HARRMOS/ummati-deco/conformite/H_Modeles_courriers.md

# H — Modèles de courriers

## H1 — Demande de déclarations RoHS / REACH à un fournisseur

> Objet : Demande de déclarations de conformité RoHS et REACH — [référence du composant]

Bonjour,

Nous intégrons votre produit **[référence exacte]** (commande n° [À COMPLÉTER] du [date]) dans un appareil électronique mis sur le marché de l'Union européenne.

Pourriez-vous nous transmettre :

1. la **déclaration de conformité RoHS** (directive 2011/65/UE modifiée par la directive (UE) 2015/863) pour cette référence ;
2. une **déclaration REACH** indiquant la présence éventuelle de substances de la liste candidate (SVHC) au-delà de 0,1 % en masse ;
3. le cas échéant, la fiche technique à jour.

Merci par avance.
[Nom] — INOMA — [e-mail]

*(English version)* Hello, we integrate your product [part number] (order [number]) into an electronic device placed on the EU market. Could you please send us: (1) the RoHS declaration of conformity (Directive 2011/65/EU as amended by (EU) 2015/863) for this part number, (2) a REACH declaration regarding SVHC substances above 0.1% w/w, (3) the current datasheet. Thank you. [Name] — INOMA

## H2 — Demande de devis à un laboratoire

> Objet : Demande de devis — pré-essais / essais CEM et sécurité, appareil radio Wi-Fi 5 V

Bonjour,

Je souhaite un devis pour un petit appareil grand public :

- lecteur audio décoratif, **Wi-Fi 2,4 GHz** via module certifié **ESP32-S3-WROOM-1** (rapports RED du module disponibles), **Bluetooth désactivé** ;
- alimentation **5 V USB-C** (chargeur non fourni), consommation max ≈ [À COMPLÉTER] W, pas de batterie ;
- boîtier plastique imprimé 3D, dimensions 170 × 78 × 150 mm ; ampli classe D 3 W, 2 haut-parleurs, LED.

Prestations souhaitées (merci de chiffrer séparément) :

1. **pré-scan** d'émissions rayonnées et conduites (demi-journée) ;
2. essais CEM selon **EN 301 489-1 / -17** ;
3. éventuellement : revue sécurité EN 62368-1, avis sur l'exploitation des rapports du module (EN 300 328), revue EN 18031-1 ;
4. possibilité de **location de créneau** pour mesures accompagnées.

Merci d'indiquer délais et conditions.
[Nom] — INOMA — [téléphone, e-mail]

## H3 — Demande de devis d'assurance RC produits

> Objet : Demande de devis — responsabilité civile professionnelle et produits (après livraison)

Bonjour,

Micro-entreprise INOMA (SIRET [À COMPLÉTER]), je fabrique et vends en ligne un **appareil électronique décoratif basse tension (5 V USB, sans batterie, sans secteur)**, en boîtier imprimé en 3D.

- Volumes prévus : [À COMPLÉTER] unités / an ; CA prévisionnel : [À COMPLÉTER] € ;
- Pays de vente : [France / UE] ; canaux : site propre, [Etsy…].

Je souhaite un devis incluant la **RC après livraison (responsabilité du fait des produits)**, la RC exploitation, et si possible une **protection juridique**. Merci de préciser plafonds, franchises, exclusions (rappel de produits, ventes hors UE).

[Nom] — [e-mail]

## H4 — Demande de documents au fabricant du module (si introuvables en ligne)

> Objet : ESP32-S3-WROOM-1 — RED test reports and EU Declaration of Conformity

Hello, we are integrating the ESP32-S3-WROOM-1 module ([exact variant, e.g. N16R8]) unmodified, with its integrated PCB antenna, into a consumer product sold in the EU. Could you please provide the EU Declaration of Conformity and the RED test reports (EN 300 328, EN 301 489-1/-17, EN 62368-1, RF exposure) for this module, as well as the latest integration / hardware design guidelines? Thank you. [Name] — INOMA

## H5 — Réponse type à une réclamation sécurité

Bonjour [Nom],

Merci de nous avoir signalé ce problème. Par précaution, **débranchez l'appareil et ne l'utilisez plus** jusqu'à notre retour. Pourriez-vous nous envoyer : le numéro de série (étiquette sous l'appareil), des photos, le chargeur utilisé et une description de ce qui s'est passé ?

Nous revenons vers vous sous 48 h avec une solution (réparation, remplacement ou remboursement).

[Nom] — INOMA
