HARRMOS/ummati-deco/conformite/AYAH_Dossier_conformite.pdf

I N O M A

# AYAH AY-R1 Dossier de conformité et de commercialisation

### Version de travail 0.1 — 2 novembre 2026

Base de travail, pas une attestation de conformité ni un avis juridique.

### Toutes les mentions [À COMPLÉTER], [À VÉRIFIER] et [PREUVE] doivent être traitées avant

signature de la déclaration UE.

# AYAH — Dossier de conformité et de commercialisation

Produit : AYAH « Radio », référence AY-R1 — marque INOMA
Version du dossier : 0.1 (brouillon) — 2 novembre 2026

⚠️ Ce dossier est une base de travail, pas une attestation de conformité ni un avis juridique. Il a été préparé avec l'aide d'une IA. Tu signes la déclaration UE : chaque affirmation doit être vraie, vérifiée et prouvée.

## Hypothèses de cette version du produit

Élément | Choix retenu | Si tu changes ce choix
Radio | Wi-Fi 2,4 GHz uniquement, module ESP32-S3-WROOM-1
certifié, antenne intégrée

Ajouter du Bluetooth → inscription Bluetooth SIG + réévaluation
Bluetooth | Désactivé dans le firmware, non annoncé | —
Contenu
audio
| | Aucun enregistrement fourni | Fournir des récitations → licences écrites
obligatoires
Alimentation USB-C 5 V, chargeur non fourni, courant limité (fusible réarmable ≤ 2 A)
| | | Fournir un chargeur → il doit être conforme et
documenté
Batterie | Aucune | Batterie → règlement batteries + essais
supplémentaires
Boîtier | Impression 3D (PLA ou PETG), visserie M3 | Changement de matière → refaire l'analyse
thermique/incendie

## Conventions

[À COMPLÉTER] : une information que toi seul connais (adresse, SIRET, numéro de lot…).
[À VÉRIFIER] : un point à confirmer dans un texte officiel, auprès d'un organisme ou d'un laboratoire. [PREUVE] : un document réel à joindre (mesure, photo, rapport, déclaration fournisseur). Ne jamais l'inventer.

## Contenu du dossier

# | Document | Rôle | Qui le voit

A Dossier technique | Démontre la conformité (RED, RoHS, sécurité, cyber) | Toi + autorités sur demande
B Déclaration UE de conformité L'engagement signé | Public (notice ou site)
C Notice d'utilisation | Consignes obligatoires en français | Client
D Étiquetage et emballage | Marquages sur l'appareil et la boîte | Client
E Documents de vente | CGV, mentions légales, confidentialité, rétractation | Client
F Démarches administratives | DEEE, emballages, médiateur, assurance, marque, Bluetooth | Toi
G Procédures internes | Lots, réclamations, rappels, failles, mises à jour | Toi
H Modèles de courriers | Demandes aux fournisseurs, labo, assureur | Toi

## Ordre de travail recommandé

1. Figer le design : composants définitifs, firmware, boîtier → remplir A §1 à §3.
2. Collecter les preuves fournisseurs (courriers H) : rapports Espressif, déclarations RoHS.
3. Faire les mesures : températures (A §6) et perturbations électromagnétiques (A §7).
4. Cybersécurité : implémenter et documenter A §8.
5. Démarches F : entreprise, éco-organisme DEEE, emballages, médiateur, assurance.
6. Rédiger notice (C), étiquettes (D), documents de vente (E).
7. Relire tout, puis signer la déclaration B.
8. Archiver l'ensemble 10 ans (une copie par version du produit).

## Ce qui reste payant (à prévoir)

Les textes des normes (EN 62368-1, EN 301 489…) sont vendus par l'AFNOR. Une consultation gratuite est parfois possible dans certaines bibliothèques et CCI [À VÉRIFIER]. Un laboratoire les applique pour toi s'il fait les essais.
Les cotisations éco-organisme / emballages / médiateur (faibles), l'assurance (recommandée).

# A — Dossier technique AYAH AY-R1

À conserver 10 ans après la mise sur le marché du dernier exemplaire. Une version du dossier par version du produit.

## 1. Identification

Champ | Valeur
Fabricant | INOMA — [À COMPLÉTER : forme juridique, nom du responsable]
Adresse postale | [À COMPLÉTER]
SIREN / SIRET | [À COMPLÉTER]
Contact | [À COMPLÉTER : e-mail dédié, ex. contact@…]
Nom commercial | AYAH « Radio »
Référence modèle | AY-R1
Variantes (coloris) | AY-R1-VE (vert), AY-R1-NO (noir), AY-R1-IV (ivoire) — électronique identique
Version matérielle | [À COMPLÉTER : ex. HW 1.0]
Version firmware | [À COMPLÉTER : ex. FW 1.0.0, empreinte SHA-256 du binaire]
Numérotation des lots | Voir G §1

## 2. Description du produit

Usage prévu : objet de décoration lumineux et lecteur audio pour usage domestique intérieur, posé sur un meuble. Permet d'écouter des fichiers audio fournis par l'utilisateur ou un service compatible, de régler le volume et l'éclairage d'ambiance. Ce n'est pas un jouet.

Utilisations exclues : extérieur, salle de bain, milieu humide, véhicule, exposition directe au soleil ou près d'une source de chaleur.

Fonctions :

lecture audio (ampli I2S 3 W, 2 haut-parleurs Ø40 mm 8 Ω en parallèle) ;
éclairage LED blanc chaud (LED adressables, intensité limitée par logiciel) ;
commandes : 3 touches tactiles capacitives, 1 encodeur rotatif avec poussoir ;
connexion Wi-Fi 2,4 GHz (IEEE 802.11 b/g/n) pour la configuration, les mises à jour et le pilotage depuis une application ;
Bluetooth matériellement présent dans le module mais désactivé par le firmware et non accessible à l'utilisateur.

Alimentation : 5 V continu par connecteur USB-C. Courant d'entrée limité par fusible réarmable [À COMPLÉTER : référence, courant de maintien ≤ 2 A]. Chargeur non fourni. Pas de batterie.

Dimensions / masse : 170 × 78 × 150 mm — [À COMPLÉTER : masse mesurée] g.

Matériaux accessibles : [À COMPLÉTER : PLA ou PETG, marque et référence du filament], visserie acier zingué ou inox, inserts laiton.

[PREUVE] Photos à joindre : vues avant, arrière, dessus, dessous, intérieur ouvert, circuit imprimé recto/verso, étiquette.

## 3. Conception et fabrication

Document | Référence / emplacement | Statut
Schéma électronique | [À COMPLÉTER : fichier, version] | ☐
Circuit imprimé (fichiers de fabrication) | [À COMPLÉTER] | ☐
Nomenclature (BOM) avec fournisseurs | Tableau §3.1 | ☐
Plans mécaniques (STL/STEP) | radio/stl, radio/step (version figée : [À COMPLÉTER : tag Git]) | ☐
Firmware (code source + binaire) | firmware/ (tag Git : [À COMPLÉTER]) | ☐
Procédure de fabrication et contrôles | G §2 | ☐

### 3.1 Nomenclature des composants critiques

Fonction | Composant | Fabricant / réf. | Fournisseur

Déclaration
RoHS

Certification utile

Module radio + MCU ESP32-S3-WROOM-1-N16R8

Espressif | [À
COMPLÉTER]
☐ | Rapports RED du module ☐
Ampli audio | MAX98357A | Analog Devices
(Maxim)

[À
COMPLÉTER]
☐ | —
Haut-parleurs ×2 | Ø40 mm 8 Ω | [À COMPLÉTER] | [À
COMPLÉTER]
☐ | —
LED | [À COMPLÉTER] | [À COMPLÉTER] | ☐ | —
Encodeur | EC11 | [À COMPLÉTER] | ☐ | —
Connecteur USB-C | [À COMPLÉTER] | ☐ | —
Fusible réarmable | [À COMPLÉTER] | ☐ | —
Boîtier | Filament [À
COMPLÉTER]
☐ | Fiche technique
(température, classement
feu) ☐
Circuit imprimé nu +
assemblage
[À COMPLÉTER] | ☐ | —

## 4. Exigences applicables et normes

Les versions des normes doivent être vérifiées dans la liste des normes harmonisées publiée au Journal officiel de l'UE (site de la Commission, « harmonised standards ») à la date de la déclaration. [À VÉRIFIER pour chaque ligne]

Texte | Exigence | Norme(s) de référence | Méthode retenue | Résultat
RED 2014/53/UE art.
3.1(a)
Santé, sécurité | EN IEC 62368-1
[version]

Évaluation sur dossier + essais thermiques (§6)

☐

Exposition aux champs EN 62479 / EN 62311 [version]

Reprise de l'évaluation du module + calcul (§5)

☐

RED art. 3.1(b) | Compatibilité
électromagnétique

EN 301 489-1 et EN 301
489-17 [versions]
Mesures sur le produit fini (§7) | ☐
RED art. 3.2 | Utilisation efficace du
spectre

EN 300 328 [version] Reprise des rapports du module certifié (§5)

☐

RED art. 3.3(d)(e)(f) —
Règlement délégué (UE)
2022/30
Cybersécurité | EN 18031-1 [version] (et
-2 si données
personnelles)

Évaluation documentée (§8) — vérifier les restrictions de la citation au JOUE

☐

Texte | Exigence | Norme(s) de référence | Méthode retenue | Résultat
RoHS 2011/65/UE (+ dir. déléguée 2015/863) | Substances dangereuses | EN IEC 63000 | Déclarations fournisseurs (§9) | ☐
Règlement (UE) 2023/988 (GPSR) | Sécurité générale | — | Analyse de risques (§10), traçabilité, information | ☐
Écoconception veille — Règlement (UE) 2023/826 | Consommation en veille / veille réseau | — | [À VÉRIFIER : applicabilité] ; mesure de la consommation au repos (§6.3) | ☐
REACH (CE 1907/2006) | Substances extrêmement préoccupantes (SVHC) | — | Déclarations fournisseurs (§9) | ☐
DEEE 2012/19/UE | Marquage, filière | — | Voir F | ☐

Non applicables (avec justification) :

Directive basse tension 2014/35/UE : couverte par la RED pour un équipement radio (et tension < 75 V continu).
EN 61000-3-2 / -3-3 (harmoniques, flicker réseau) : appareil alimenté en 5 V continu, non raccordé directement au réseau 230 V [À VÉRIFIER avec le labo].
Règlement batteries : aucune batterie.
Directive jouets : produit non destiné aux enfants de moins de 14 ans, mention « Ce n'est pas un jouet ».

## 5. Radio et exposition aux ondes — intégration du module certifié

Principe : les essais radio (EN 300 328) et l'évaluation d'exposition sont repris des rapports du fabricant du module, à condition de respecter strictement ses consignes d'intégration.

Condition d'intégration (guide Espressif) | Respectée ? | Preuve
Module utilisé sans modification, antenne PCB intégrée d'origine | ☐ | Photo du circuit
Zone sans cuivre / sans métal sous et autour de l'antenne (selon le guide) | ☐ | Plan du circuit
Antenne éloignée des vis, inserts, haut-parleurs (aimants) | ☐ | Photo intérieur
Puissance d'émission et paramètres radio non modifiés au-delà des réglages autorisés | ☐ | Extrait firmware
Bandes : 2,4 GHz uniquement | ☐ | —

[PREUVE] À télécharger chez Espressif et joindre : déclaration UE et rapports d'essais RED du module ESP32-S3-WROOM-1 (EN 300 328, EN 301 489, EN 62368-1, évaluation d'exposition), et le guide de conception matérielle du module. Noter la version et la date de chaque document.

Exposition : [À COMPLÉTER : puissance maximale déclarée par le module, conclusion de l'évaluation du module, distance d'utilisation (> 20 cm en usage normal, objet posé)].

## 6. Sécurité électrique et thermique (EN IEC 62368-1)

### 6.1 Classification des sources d'énergie [À VÉRIFIER avec le texte de la norme]

Énergie | Classe visée Justification
Électrique | ES1 | 5 V continu
Puissance (incendie) | PS1 visé | Puissance disponible limitée à ≤ 15 W par fusible réarmable ≤ 2 A — [PREUVE : mesure
de la puissance max. disponible en défaut] Thermique (surfaces
touchables)
TS1 visé | Mesures §6.2
Mécanique | MS1 | Objet léger, stable, pas de pièce mobile dangereuse, bords arrondis

Énergie

Classe
visée

Justification

Rayonnement (LED) | RS1 visé | LED d'éclairage d'ambiance, intensité limitée — [À VÉRIFIER]

### 6.2 Essai d'échauffement — protocole

1. Appareil assemblé, fermé, posé sur un support bois, pièce à 23 ± 2 °C.
2. Alimentation 5 V avec un chargeur conforme 3 A.
3. Cas le plus défavorable : volume maximal (bruit rose ou récitation forte), LED à l'intensité maximale autorisée par le firmware, Wi-Fi actif, 4 h minimum (jusqu'à stabilisation).
4. Thermocouples ou sonde sur : ESP32, ampli, LED, connecteur USB, fusible, boîtier intérieur au plus chaud, surfaces extérieures touchables (dessus, grille, molette).
5. Cas de défaut : un haut-parleur en court-circuit, LED bloquées à 100 % (si possible par logiciel), sortie de l'ampli en court-circuit [À VÉRIFIER : défauts à simuler selon la norme].
Point de mesure | T max mesurée (°C) | Limite applicable | OK ?
Surface extérieure dessus | [PREUVE] | [À VÉRIFIER : limite de toucher pour plastique] | ☐
Grille / molette | [PREUVE] | ☐
Boîtier intérieur (près ampli) [PREUVE] | < température de ramollissement du filament – marge (PLA ≈ 55 °C) ☐
ESP32 | [PREUVE] | Selon fiche technique | ☐
Ampli | [PREUVE] | Selon fiche technique | ☐
Connecteur USB | [PREUVE] | ☐

[PREUVE] Photos du montage d'essai, relevés horodatés.

### 6.3 Consommation

Mode | Puissance mesurée (W)
Lecture volume max + LED max | [PREUVE]
Repos, LED éteintes, Wi-Fi connecté (veille réseau) | [PREUVE]
Repos, Wi-Fi coupé | | | [PREUVE]

### 6.4 Autres points de sécurité

Matériau du boîtier : [À COMPLÉTER : classement au feu du filament si disponible]. En PS1, pas d'exigence d'enveloppe coupe-feu [À VÉRIFIER].
Aucune arête vive ; petites pièces (touches, molette) non détachables sans outil — [PREUVE : essai de traction, ex. 50 N] [À VÉRIFIER valeur].
Stabilité : ne bascule pas sur un plan incliné de 10° [À VÉRIFIER] — [PREUVE].
Chute d'une table (≈ 75 cm) : pas de pièce dangereuse accessible — [PREUVE].

## 7. Compatibilité électromagnétique (EN 301 489-1 / -17)

Méthode : [À CHOISIR : essais complets en laboratoire / pré-tests maison + demi-journée en laboratoire].

### 7.1 Plan d'essais

Phénomène | Essai | Port | Configuration | Critère d'aptitude
Émissions rayonnées | Selon EN 301 489-1 (renvoi EN 55032, classe B) | Enveloppe | Lecture audio volume max + LED + Wi-Fi | Limites classe B

Phénomène | Essai | Port | Configuration | Critère d'aptitude
Émissions conduites | Idem | Câble USB (via
chargeur de référence)
Idem | Limites classe B

Décharges
électrostatiques
EN 61000-4-2 | Touches, molette, grille,
vis, USB

En fonctionnement Critère B (récupération seule) [À VÉRIFIER]
Champ rayonné | EN 61000-4-3 | Enveloppe | Lecture | Critère A [À VÉRIFIER]
Transitoires rapides /
ondes de choc

EN 61000-4-4 / -4-5 Alimentation (si applicable, via
chargeur)

[À VÉRIFIER
applicabilité pour port
DC]
Perturbations conduites
RF
EN 61000-4-6 | Câble USB | [À VÉRIFIER]

### 7.2 Résultats

Essai | Lieu, date, matériel (n° de série, étalonnage) | Résultat | Marge | Conforme ?
[PREUVE] | [PREUVE] | ☐

Mesures de conception déjà prises : plan de masse, découplages, ferrites sur USB et fils HP, fils HP courts et torsadés, résistances série sur horloges I2S/SPI, modulation étalée de l'ampli active.

## 8. Cybersécurité (EN 18031-1)

Structure à confronter au texte de la norme (mécanismes : contrôle d'accès, authentification, mise à jour sécurisée, stockage sécurisé, communication sécurisée, résilience, surveillance réseau, contrôle du trafic, clés cryptographiques confidentielles, capacités générales, cryptographie). [À VÉRIFIER : restrictions de présomption de conformité dans la citation au JOUE — certains choix imposent un organisme notifié.]

Mécanisme | Mise en œuvre AYAH | Preuve
Pas de mot de passe par
défaut commun

Configuration initiale : point d'accès temporaire protégé par un code unique par appareil imprimé sous l'appareil, ou appairage par l'appli avec confirmation physique (appui molette)

Extrait de code,
procédure

Authentification des
commandes réseau

API locale accessible uniquement après appairage ; jeton unique par appareil ; aucune commande sans authentification

☐

Mises à jour sécurisées OTA signées (vérification de signature avant installation), démarrage sécurisé (Secure Boot v2) et chiffrement de la flash activés en production, retour arrière automatique en cas d'échec

☐

Stockage sécurisé | Identifiants Wi-Fi et jetons stockés en NVS chiffrée ; aucun secret en clair dans les
journaux

☐

Communication sécurisée TLS pour tout échange avec un serveur ; vérification du certificat | ☐
Résilience | Limitation des tentatives, redémarrage sûr, chien de garde | ☐
Surface d'attaque
minimale

Bluetooth désactivé ; aucun port de débogage accessible ; services réseau limités au strict nécessaire

☐

Réinitialisation | Remise à zéro usine (appui long) effaçant identifiants et jetons | ☐
Gestion des vulnérabilités Procédure G §5 | ☐
Données personnelles | [À COMPLÉTER : aucune / liste] — si oui, EN 18031-2 et RGPD | ☐

## 9. Substances (RoHS, REACH)

Composant | Déclaration RoHS reçue (date) | Déclaration REACH / SVHC | Commentaire
(un par ligne de la nomenclature §3.1) | [PREUVE] | [PREUVE]

Méthode : approche EN IEC 63000 — collecte des déclarations fournisseurs, évaluation des fournisseurs, archivage. Modèle de demande : H §1.

## 10. Analyse de risques (sécurité générale)

Gravité : 1 mineure · 2 sérieuse · 3 grave. Probabilité : 1 rare · 2 possible · 3 probable.

# | Danger | Situation | G | P | Mesures

G×P
résiduel

Preuve

1 Échauffement /

| incendie | Utilisation prolongée, nuit, volume max

3 1 5 V limité, fusible, LED limitées, mesures
| | | | | §6.2, consignes notice
faible | §6.2

2 Déformation du
| boîtier

Soleil, voiture, radiateur 1 2 Consigne notice, filament [PETG
| | | | | recommandé]
faible | Notice

3 Ingestion de petites
| pièces
Enfant en bas âge | 3 1 Pièces non détachables sans outil, mention
| | | | | « hors de portée des jeunes enfants »
faible | §6.4
4 Choc électrique | — | 1 1 ES1 (5 V), pas de secteur dans l'appareil | négligeable §6.1
5 Chargeur non
| conforme | Client utilise un chargeur bas de gamme

2 2 Notice : « chargeur conforme CE 5 V / 3 A »
| | | | | ; fusible d'entrée
faible | Notice
6 Chute de l'objet | Bord de meuble | 1 2 Patins antidérapants, centre de gravité bas faible | §6.4
7 Volume sonore élevé Écoute proche | 1 1 Puissance 3 W, volume max limité par
| | | | | logiciel

négligeable —

8 Lumière
| (éblouissement)
Mode nuit | 1 1 LED diffusées, intensité limitée | négligeable —

9 Piratage / prise de
| contrôle
Réseau domestique | 2 2 Mesures §8 | faible | §8

10 Arêtes / bavures
| d'impression
Manipulation | 1 2 Contrôle visuel en fin de fabrication,
| | | | | ébavurage
faible | G §2

## 11. Conclusion et signature

La conformité est déclarée lorsque toutes les cases ☐ ci-dessus sont cochées avec leur preuve.

Établi par : [À COMPLÉTER], le [À COMPLÉTER] — Version du dossier : [À COMPLÉTER]

# B — Déclaration UE de conformité

Modèle à compléter uniquement après avoir terminé le dossier technique (A). Langue : français (ajouter les langues des autres pays de vente). À fournir avec le produit (intégrale ou simplifiée avec lien internet).

## DÉCLARATION UE DE CONFORMITÉ

N° : DoC-AY-R1-[À COMPLÉTER : version, ex. 01]

1. Produit : lecteur audio décoratif avec éclairage et connexion Wi-Fi Nom commercial : AYAH « Radio » Modèle / type : AY-R1 (variantes coloris AY-R1-VE, AY-R1-NO, AY-R1-IV) Version matérielle : [À COMPLÉTER] — Version logicielle : [À COMPLÉTER] Numéros de lot / série concernés : à partir du lot [À COMPLÉTER]
2. Fabricant : INOMA, [À COMPLÉTER : forme juridique], [À COMPLÉTER : adresse postale complète], France — [À COMPLÉTER : e-mail]
3. La présente déclaration de conformité est établie sous la seule responsabilité du fabricant.
4. Objet de la déclaration : l'appareil décrit au point 1, identifiable par l'étiquette portant sa référence et son numéro de lot. [Insérer une photo du produit — facultatif]
5. L'objet de la déclaration décrit ci-dessus est conforme à la législation d'harmonisation de l'Union applicable :
6. Directive 2014/53/UE (équipements radioélectriques), y compris le règlement délégué (UE) 2022/30 (articles 3.3 d, e, f) ;
7. Directive 2011/65/UE (RoHS), modifiée par la directive déléguée (UE) 2015/863.
8. [À VÉRIFIER : règlement (UE) 2023/826 si applicable]
9. Références des normes harmonisées appliquées (ou autres spécifications techniques) :
10. Article 3.1(a) — Sécurité : EN IEC 62368-1:[version] ; exposition : EN 62479:[version] ou EN 62311:[version]
11. Article 3.1(b) — CEM : EN 301 489-1 V[version] ; EN 301 489-17 V[version]
12. Article 3.2 — Spectre radio : EN 300 328 V[version]
13. Article 3.3(d)(e)(f) — Cybersécurité : EN 18031-1:[version]
14. RoHS : EN IEC 63000:[version]

[À VÉRIFIER] chaque version dans la liste officielle au JOUE à la date de signature.

15. Organisme notifié : sans objet — procédure d'évaluation : contrôle interne de la fabrication (annexe II de la directive 2014/53/UE).

⚠️ Si une norme n'est pas appliquée entièrement (ou si la citation de l'EN 18031-1 au JOUE l'exclut pour ton design), cette procédure n'est pas possible : un organisme notifié devient obligatoire.

16. Informations complémentaires : bande de fréquences 2 400–2 483,5 MHz ; puissance maximale émise : [À COMPLÉTER : valeur déclarée par le fabricant du module] dBm (PIRE). Accessoires : aucun chargeur fourni ; logiciel : firmware version [À COMPLÉTER].

Signé par et au nom de : INOMA

Lieu et date : [À COMPLÉTER], le [À COMPLÉTER]

Nom, fonction : [À COMPLÉTER], [ex. dirigeant]

Signature : ______________________

## Version simplifiée (à imprimer dans la notice)

Le soussigné, INOMA, déclare que l'équipement radioélectrique du type AYAH AY-R1 est conforme à la directive 2014/53/UE. Le texte complet de la déclaration UE de conformité est disponible à l'adresse internet suivante : [À COMPLÉTER : URL]

# C — Notice d'utilisation AYAH

Texte prêt à mettre en page (format A6 ou A5). Obligatoire en français. Adapter si le produit change. Relire avec le firmware final.

# AYAH « Radio »

Lecteur audio décoratif — modèle AY-R1

Merci d'avoir choisi AYAH. Lisez cette notice avant la première utilisation et conservez-la.

## Contenu de la boîte

1 AYAH « Radio »
Cette notice
[À COMPLÉTER : câble USB-C fourni ou non]

Chargeur non fourni. Utilisez un chargeur USB-C conforme CE, 5 V, 3 A minimum (par exemple celui d'un téléphone récent).

## Consignes de sécurité ⚠️

Usage intérieur uniquement, dans un endroit sec. Ne pas exposer à l'eau, à l'humidité ni aux projections. Ne pas placer au soleil direct, dans une voiture, ni près d'un radiateur ou d'une flamme : le boîtier imprimé peut se déformer à la chaleur.
Ne pas couvrir l'appareil pendant son fonctionnement.
Utiliser uniquement un chargeur conforme. Débrancher en cas d'odeur, de chaleur anormale ou de bruit inhabituel.
Ne pas ouvrir l'appareil branché. Aucune pièce réparable par l'utilisateur à l'intérieur, en dehors de celles décrites dans cette notice.
Ce n'est pas un jouet. Tenir hors de portée des enfants de moins de 3 ans (petites pièces).
Écouter à un volume modéré.
Posé sur une surface stable et plane, à distance du bord.

## Découvrir AYAH

Molette dorée (à droite) : tourner pour régler le volume ; appuyer pour lecture / pause ; [À COMPLÉTER : appui long = mode navigation / mode nuit].
Touches ◀ ⏯ ▶ : piste précédente, lecture/pause, piste suivante. Ce sont des touches tactiles : un simple effleurement suffit.
Éclairage : [À COMPLÉTER : comment allumer / régler / mode nuit].

## Mise en service

1. Posez AYAH sur une surface stable.
2. Branchez le câble USB-C au dos, puis au chargeur.
3. L'éclairage s'allume doucement : AYAH est prêt.

4. Connexion Wi-Fi (facultative) : [À COMPLÉTER : procédure avec l'application, code d'appairage unique situé sous l'appareil].

## Contenu audio

AYAH ne contient aucun enregistrement. [À COMPLÉTER selon la version : « Copiez vos propres fichiers MP3 sur la carte microSD » / « Choisissez un contenu depuis l'application compatible »]. Utilisez uniquement des contenus dont vous avez le droit de vous servir.

## Réinitialisation

Pour effacer les réglages et la connexion Wi-Fi : [À COMPLÉTER : ex. maintenir la molette enfoncée 10 secondes, appareil branché].

## Entretien

Dépoussiérer avec un chiffon sec et doux. Pas de produit liquide, pas d'eau.

## En cas de problème

Problème | Solution
Rien ne s'allume | Vérifier le chargeur (5 V / 3 A) et le câble
Pas de son | Monter le volume (molette) ; vérifier qu'un contenu est disponible
L'appareil redémarre au volume fort | Utiliser un chargeur plus puissant (3 A)
Wi-Fi introuvable | Réinitialiser l'appareil, recommencer la mise en service

## Caractéristiques techniques

Alimentation | 5 V ⎓, USB-C, [À COMPLÉTER : consommation max mesurée] W
Wi-Fi | IEEE 802.11 b/g/n, 2 400–2 483,5 MHz, puissance max. [À COMPLÉTER] dBm
Son | 2 haut-parleurs, amplificateur 3 W
Dimensions | 170 × 78 × 150 mm
Masse | [À COMPLÉTER] g
Température d'utilisation | [À COMPLÉTER : ex. 5 à 35 °C]
Mises à jour logicielles | Assurées au moins jusqu'au [À COMPLÉTER : date]

## Garanties

Ce produit bénéficie de la garantie légale de conformité (2 ans) et de la garantie des vices cachés. Voir les conditions générales de vente. Service client : [À COMPLÉTER : e-mail].

## Déclaration de conformité

Le soussigné, INOMA, déclare que l'équipement radioélectrique du type AYAH AY-R1 est conforme à la directive 2014/53/UE. Le texte complet de la déclaration UE de conformité est disponible à l'adresse : [À COMPLÉTER : URL].

## Recyclage

![poubelle barrée] Ce produit ne doit pas être jeté avec les ordures ménagères. Déposez-le dans un point de collecte d'équipements électriques (déchetterie, magasin). [À COMPLÉTER : mention de l'éco-organisme + Info-tri si requise]

## Fabricant

INOMA — [À COMPLÉTER : adresse postale] — [À COMPLÉTER : e-mail] — Modèle AY-R1 — Lot : voir étiquette sous l'appareil.

# D — Étiquetage de l'appareil et de l'emballage

## 1. Étiquette sous l'appareil (obligatoire)

Étiquette imprimée résistante (polyester) ou gravure directe dans le socle. Lisible, indélébile.

AYAH « Radio » | Modèle : AY-R1
Lot : AY-R1-2026-001 | N° : 0001
INOMA — [adresse postale] — [e-mail ou site]
5 V ⎓ [x] A — USB-C
Code d'appairage : XXXX-XXXX | (si prévu, unique par appareil)
CE | [poubelle barrée] | Fabriqué en France
Mention | Règle | Statut
Marquage CE | Hauteur ≥ 5 mm, proportions officielles, apposé après la déclaration | ☐
Poubelle barrée (DEEE) | Symbole de la norme EN 50419 ; barre noire sous la poubelle si exigée
(date de mise sur le marché) [À VÉRIFIER]

☐

Nom, raison sociale ou marque et adresse
postale du fabricant
Plus un moyen de contact électronique (GPSR) | ☐
Type / modèle + numéro de lot ou de série | Pour la traçabilité | ☐
Caractéristiques d'alimentation | 5 V ⎓, courant | ☐

Si la place manque sur l'appareil, certaines mentions (adresse) peuvent figurer sur l'emballage et la notice [À VÉRIFIER selon chaque texte] — le CE, le modèle et le lot restent sur l'appareil.

## 2. Emballage

Mention | Statut
Nom du produit, modèle, lot | ☐
Fabricant + adresse + contact | ☐
Marquage CE (recommandé aussi sur la boîte) | ☐
Poubelle barrée | ☐
Logo Triman + Info-tri pour l'emballage et le produit (règles françaises de tri) — [À VÉRIFIER : modèle à jour fourni par
ton éco-organisme emballages]

☐

« Chargeur non fourni » | ☐
« Ce n'est pas un jouet » / « Ne convient pas aux enfants de moins de 3 ans » (si petites pièces) | ☐
Pas de mention trompeuse (« certifié », « norme CE validée par… », logo Bluetooth si non inscrit) | ☐

## 3. Notice

La notice (C) accompagne chaque appareil, en français. Elle contient la déclaration de conformité simplifiée et les consignes de sécurité.

## 4. Mentions interdites ou à éviter

« Approuvé par l'Union européenne », « certifié CE » : le CE est une auto-déclaration, pas un label. Logo ou mot Bluetooth si non inscrit au Bluetooth SIG.

Logo Wi-Fi CERTIFIED sans certification Wi-Fi Alliance (le mot « Wi-Fi » descriptif reste possible [À VÉRIFIER]).
Promesses environnementales générales (« écologique », « neutre en carbone ») : encadrées par la loi.

# E — Documents de vente en ligne (vente aux particuliers)

Modèles de base pour une micro-entreprise vendant en France. Faire relire (CCI, juriste) avant mise en ligne. Les textes officiels à recopier mot pour mot sont signalés : les prendre sur Légifrance, pas de mémoire.

## E1 — Conditions générales de vente (CGV)

Article 1 — Vendeur. INOMA, [forme juridique], [adresse], SIRET [À COMPLÉTER], e-mail [À COMPLÉTER], téléphone [facultatif]. [Si franchise de TVA : « TVA non applicable, art. 293 B du CGI ».]

Article 2 — Objet. Les présentes CGV régissent la vente à distance des produits AYAH aux consommateurs, via le site [À COMPLÉTER]. Toute commande vaut acceptation des CGV en vigueur au jour de la commande.

Article 3 — Produits. Les caractéristiques essentielles figurent sur chaque fiche produit (dimensions, alimentation, fonctions, chargeur non fourni, aucun contenu audio fourni). Les produits sont fabriqués à la main par impression 3D : de légères variations d'aspect sont possibles et ne constituent pas un défaut.

Article 4 — Prix. Prix en euros TTC [ou « TVA non applicable »], hors frais de livraison indiqués avant validation. Éco-participation incluse et affichée séparément : [À COMPLÉTER] €.

Article 5 — Commande. Étapes : choix du produit, panier, identification, récapitulatif, bouton « Commander avec obligation de paiement », paiement, confirmation par e-mail (récapitulatif + CGV en pièce jointe).

Article 6 — Paiement. Par [carte bancaire via Stripe / PayPal]. Paiement exigible à la commande.

Article 7 — Livraison. Zones : [France métropolitaine / UE]. Délai : [À COMPLÉTER] jours ouvrés après paiement (fabrication incluse). À défaut d'indication, livraison au plus tard 30 jours après la commande. En cas de retard, le client peut résoudre la vente dans les conditions légales. Transfert des risques à la remise du colis au client.

Article 8 — Droit de rétractation. Le client dispose de 14 jours à compter de la réception pour se rétracter, sans motif, en utilisant le formulaire (E4) ou toute déclaration claire. Retour du produit dans les 14 jours suivant la rétractation, frais de retour à la charge du client [ou : pris en charge par INOMA]. Remboursement de toutes les sommes versées, y compris les frais de livraison standard, sous 14 jours, par le même moyen de paiement. Le vendeur peut différer le remboursement jusqu'à récupération du produit. La responsabilité du client peut être engagée en cas de dépréciation du produit résultant de manipulations autres que celles nécessaires pour établir sa nature, ses caractéristiques et son bon fonctionnement.

Si tu proposes une personnalisation (gravure d'un nom…) : le droit de rétractation ne s'applique pas aux biens nettement personnalisés — l'indiquer clairement sur la fiche produit [À VÉRIFIER].

Article 9 — Garanties légales. Le vendeur est tenu de la garantie légale de conformité (articles L. 217-1 et suivants du Code de la consommation) et de la garantie des vices cachés (articles 1641 et suivants du Code civil).

Obligatoire : insérer ici, mot pour mot, l'encadré d'information sur la garantie légale de conformité prévu par la réglementation (décret n° 2022-946 du 29 juin 2022) — [À COPIER depuis Légifrance].

Article 10 — Pièces détachées et mises à jour. Pièces détachées indispensables à l'utilisation disponibles jusqu'au [À COMPLÉTER : date ou « information non disponible »] (mention obligatoire pour les équipements électriques — [À VÉRIFIER]). Mises à jour logicielles de sécurité fournies au moins jusqu'au [À COMPLÉTER].

Article 11 — Responsabilité. Le vendeur n'est pas responsable des contenus audio ajoutés par l'utilisateur, ni d'une utilisation non conforme à la notice (chargeur non conforme, exposition à la chaleur ou à l'humidité).

Article 12 — Données personnelles. Voir la politique de confidentialité (E3).

Article 13 — Médiation. En cas de litige non résolu avec le service client, le consommateur peut recourir gratuitement au médiateur de la consommation : [À COMPLÉTER : nom, site internet, adresse du médiateur choisi]. Plateforme européenne de règlement en ligne des litiges : [À VÉRIFIER : la plateforme RLL de la Commission a été fermée / modifiée — vérifier si la mention est encore requise].

Article 14 — Droit applicable. Droit français. Le consommateur bénéficie des dispositions impératives de la loi de son pays de résidence.

## E2 — Mentions légales du site

Éditeur : INOMA, [forme juridique], [adresse], SIRET [À COMPLÉTER], e-mail [À COMPLÉTER].
Directeur de la publication : [À COMPLÉTER].
Hébergeur : [nom, adresse, téléphone de l'hébergeur — À COMPLÉTER].
Propriété intellectuelle : textes, photos, modèles et marques « AYAH » et « INOMA » [déposées / en cours de dépôt — À COMPLÉTER].

## E3 — Politique de confidentialité (site + application)

Rubrique | Contenu
Responsable du traitement | INOMA, [adresse], [e-mail]
Données collectées | Commande : nom, adresse, e-mail, téléphone (facultatif), historique de commande. Paiement : traité par [Stripe/PayPal], INOMA ne voit pas les numéros de carte. Appareil / appli : [À COMPLÉTER : aucune donnée / identifiant d'appareil, adresse IP, version firmware pour les mises à jour]
Finalités et bases légales | Exécution de la commande (contrat) ; obligations comptables (obligation légale) ; service après-vente et sécurité des appareils, mises à jour (intérêt légitime / contrat) ; newsletter (consentement, si proposée)
Durée de conservation | Données de commande : durée de la relation + délais légaux (pièces comptables : 10 ans) ; prospects : 3 ans sans contact [À VÉRIFIER]
Destinataires | INOMA ; prestataires : hébergeur, paiement, transporteur
Transferts hors UE | [À COMPLÉTER : aucun / prestataire concerné + garanties]
Droits | Accès, rectification, effacement, opposition, limitation, portabilité : écrire à [e-mail]. Réclamation possible auprès de la CNIL (cnil.fr)
Cookies | Uniquement les cookies nécessaires [sinon bandeau de consentement]
Sécurité | Chiffrement des échanges (HTTPS / TLS), accès restreint

L'appareil lui-même : collecter le minimum (idéalement aucune donnée personnelle). Si l'appli crée des comptes, compléter cette politique et l'analyse EN 18031-2.

## E4 — Formulaire de rétractation

Le modèle officiel figure en annexe de l'article R. 221-1 du Code de la consommation : le recopier depuis Légifrance. Contenu :

« À l'attention de INOMA, [adresse], [e-mail] : Je/nous () vous notifie/notifions () par la présente ma/notre () rétractation du contrat portant sur la vente du bien ci-dessous : — Commandé le () / reçu le () : — Nom du (des) consommateur(s) : — Adresse du (des) consommateur(s) : — Signature du (des) consommateur(s) (uniquement en cas de notification du présent formulaire sur papier) : — Date : () Rayez la mention inutile. »

## E5 — Fiche produit en ligne (informations obligatoires, GPSR)

Sur chaque annonce (site, Etsy, Amazon…) :

nom du fabricant (INOMA), adresse postale et adresse électronique ;
identification du produit : nom, modèle AY-R1, photo ;
avertissements et consignes de sécurité essentiels (usage intérieur, chargeur conforme non fourni, pas un jouet) en français ;
caractéristiques essentielles, prix TTC + éco-participation, frais et délais de livraison ;
droit de rétractation, garanties légales, disponibilité des pièces détachées ;
« Aucun contenu audio fourni ».

# F — Démarches administratives avant la première vente

Coûts indicatifs, à vérifier. Cocher au fur et à mesure et garder les justificatifs dans le dossier.

# | Démarche | Où | Coût estimé | Fait

1 Créer / vérifier l'entreprise : activité déclarée
| couvrant la fabrication et la vente d'appareils électroniques et d'objets décoratifs | Guichet unique INPI (formalites.entreprises.gouv.fr) | 0 € | ☐

2 Compte bancaire dédié (conseillé, obligatoire au-delà
d'un certain CA en micro-entreprise [À VÉRIFIER])
Banque en ligne | 0 € possible | ☐

3 Recherche d'antériorité « AYAH », « INOMA » (classes 9, 11, 20 [À VÉRIFIER classes])

data.inpi.fr, EUIPO eSearch, WIPO
Global Brand DB
0 € | ☐
4 Dépôt de marque (facultatif, conseillé) | INPI | ≈ 190 € (1 classe) [À
VÉRIFIER]

☐

5 Adhésion à un éco-organisme DEEE (équipements
électriques ménagers) → obtention de l'IDU (identifiant unique)

ecosystem, Ecologic… + registre ADEME (SYDEREP)

quelques centimes /
appareil + adhésion
éventuelle

☐

6 REP emballages ménagers → IDU emballages | Citeo, Léko… | faible pour petits
volumes

☐

7 Afficher l'IDU sur le site et dans les CGV (et le
transmettre aux places de marché)
— | 0 € | ☐

8 Médiateur de la consommation : adhérer et afficher ses coordonnées

Liste des médiateurs agréés
(CECMC)
faible / à l'acte | ☐

9 Assurance RC produits (après livraison) — préciser : appareil électronique 5 V USB, impression 3D, volumes, pays

Banque, assureur en ligne, courtier | ≈ 200–800 € / an | ☐

10 Bluetooth : confirmer qu'il est désactivé et non annoncé (sinon inscription Bluetooth SIG payante)

— | 0 € | ☐

11 Contenu audio : confirmer qu'aucun enregistrement n'est fourni (sinon licences écrites)

— | 0 € | ☐

12 Police calligraphique : remplacer par une police libre d'usage commercial (ex. Amiri, OFL) ou calligraphie avec cession de droits

— | 0 € | ☐

13 Documents Espressif du module (rapports RED, DoC, guide matériel)

Site Espressif / distributeur | 0 € | ☐

14 Déclarations RoHS/REACH des fournisseurs (modèle H §1)

Fournisseurs | 0 € | ☐

15 Mesures thermiques + perturbations électromagnétiques (A §6, §7)

Maison / labo à l'heure | ≈ 300–1 500 € | ☐

16 Signer la déclaration UE (B), publier la version complète en ligne

— | 0 € | ☐

17 Mettre en ligne CGV, mentions légales, confidentialité
(E)
— | 0 € | ☐
18 Étiquettes, notice, emballage conformes (C, D) | — | quelques centimes /
unité

☐

## Après le lancement (récurrent)

Déclarations de chiffre d'affaires (mensuelles ou trimestrielles) et cotisations.
Déclaration annuelle des quantités mises sur le marché à l'éco-organisme DEEE et emballages. Suivi des réclamations, des failles et des mises à jour (G).
Mise à jour du dossier technique à chaque modification (composant, firmware, boîtier).
Préparer l'application du Cyber Resilience Act (signalement des vulnérabilités activement exploitées, application générale prévue fin 2027) [À VÉRIFIER : calendrier et obligations exactes].

# G — Procédures internes

## G1 — Identification et traçabilité des lots

Format : AY-R1-AAAA-LLL (année + numéro de lot), numéro de série 0001, 0002… dans le lot.
Un lot = même version matérielle + même version firmware + même lot de filament + mêmes fournisseurs. Registre de production (tableur) — une ligne par appareil :

N°
série

Lot Date

Version
HW

Version
FW

Filament
(lot)

Fournisseur ESP32
(commande)

Contrôle final
OK

Client /
commande

Conserver les factures fournisseurs (preuve d'origine des composants) 10 ans.

## G2 — Contrôle de fabrication (chaque appareil)

# | Contrôle | Critère | OK

1 Aspect | Pas de bavure, d'arête vive, de fissure | ☐
2 Fixations | Toutes les vis serrées, touches et molette non détachables à la main | ☐
3 Antenne | Rien de métallique ajouté près du module (conforme au dossier A §5) | ☐
4 Mise sous tension | Démarrage, éclairage, son sur les 2 haut-parleurs | ☐
5 Commandes | 3 touches + molette (rotation et appui) | ☐
6 Firmware | Version attendue, démarrage sécurisé activé, code d'appairage unique programmé | ☐
7 Échauffement rapide | 15 min volume fort : pas d'odeur, pas de chaleur anormale | ☐
8 Étiquette | CE, DEEE, modèle, lot, série, adresse, code d'appairage | ☐
9 Emballage | Notice, mentions, Triman / Info-tri | ☐

## G3 — Réclamations clients

1. Enregistrer chaque réclamation : date, n° de série, description, photos.
2. Classer : sécurité (chaleur, odeur, fumée, blessure) / fonctionnement / aspect.
3. Toute réclamation de sécurité → analyse sous 48 h, vérification des autres appareils du même lot.
4. Réponse au client, réparation / remplacement / remboursement selon garanties.
5. Revue mensuelle : les mêmes problèmes reviennent-ils ? → action corrective + mise à jour du dossier.

## G4 — Produit dangereux : alerte et rappel (GPSR)

Si un risque pour la sécurité est identifié :

1. Arrêter immédiatement la vente du lot concerné.
2. Signaler sans délai aux autorités via le Safety Business Gateway de la Commission européenne (obligation du fabricant en cas de produit dangereux) [À VÉRIFIER : modalités] ; en France, autorités compétentes : DGCCRF (et ANFR pour la conformité radio/CEM).
3. Informer les clients du lot (e-mail, site) avec une consigne claire (débrancher, ne plus utiliser).
4. Proposer un remède (réparation, remplacement ou remboursement).
5. Documenter toutes les actions dans le dossier.
6. Publier l'avis de rappel si requis (site officiel Rappel Conso en France) [À VÉRIFIER].

## G5 — Vulnérabilités et mises à jour (cybersécurité)

Contact sécurité public : securite@[domaine] (ou formulaire) indiqué sur le site.
Traitement : accusé de réception sous 5 jours ouvrés ; évaluation ; correctif ; mise à jour OTA signée ; information des clients.
Vulnérabilité activement exploitée : obligations de signalement au titre du Cyber Resilience Act [À VÉRIFIER : délais et plateforme].
Durée de support annoncée (notice + CGV) : mises à jour de sécurité jusqu'au [À COMPLÉTER]. Clés de signature du firmware : stockées hors ligne, sauvegardées, jamais dans le dépôt Git. Journal des versions publiées : version, date, empreinte, contenu, failles corrigées.

## G6 — Gestion des modifications

Toute modification (composant, fournisseur, firmware, boîtier, filament) :

1. Évaluer l'impact sur la conformité (radio, CEM, thermique, cyber, RoHS).
2. Refaire les essais concernés si nécessaire.
3. Nouvelle version du dossier technique (+ nouvelle déclaration si le produit change de façon substantielle).
4. Nouveau lot.

# H — Modèles de courriers

## H1 — Demande de déclarations RoHS / REACH à un fournisseur

Objet : Demande de déclarations de conformité RoHS et REACH — [référence du composant]

Bonjour,

Nous intégrons votre produit [référence exacte] (commande n° [À COMPLÉTER] du [date]) dans un appareil électronique mis sur le marché de l'Union européenne.

Pourriez-vous nous transmettre :

1. la déclaration de conformité RoHS (directive 2011/65/UE modifiée par la directive (UE) 2015/863) pour cette référence ;
2. une déclaration REACH indiquant la présence éventuelle de substances de la liste candidate (SVHC) au-delà de 0,1 % en masse ;
3. le cas échéant, la fiche technique à jour.

Merci par avance. [Nom] — INOMA — [e-mail]

(English version) Hello, we integrate your product [part number] (order [number]) into an electronic device placed on the EU market. Could you please send us: (1) the RoHS declaration of conformity (Directive 2011/65/EU as amended by (EU) 2015/863) for this part number, (2) a REACH declaration regarding SVHC substances above 0.1% w/w, (3) the current datasheet. Thank you. [Name] — INOMA

## H2 — Demande de devis à un laboratoire

Objet : Demande de devis — pré-essais / essais CEM et sécurité, appareil radio Wi-Fi 5 V

Bonjour,

Je souhaite un devis pour un petit appareil grand public :

lecteur audio décoratif, Wi-Fi 2,4 GHz via module certifié ESP32-S3-WROOM-1 (rapports RED du module disponibles), Bluetooth désactivé ;
alimentation 5 V USB-C (chargeur non fourni), consommation max ≈ [À COMPLÉTER] W, pas de batterie ; boîtier plastique imprimé 3D, dimensions 170 × 78 × 150 mm ; ampli classe D 3 W, 2 haut-parleurs, LED.

Prestations souhaitées (merci de chiffrer séparément) :

1. pré-scan d'émissions rayonnées et conduites (demi-journée) ;
2. essais CEM selon EN 301 489-1 / -17 ;
3. éventuellement : revue sécurité EN 62368-1, avis sur l'exploitation des rapports du module (EN 300 328), revue EN 18031-1 ;
4. possibilité de location de créneau pour mesures accompagnées.

Merci d'indiquer délais et conditions. [Nom] — INOMA — [téléphone, e-mail]

## H3 — Demande de devis d'assurance RC produits

Objet : Demande de devis — responsabilité civile professionnelle et produits (après livraison)

Bonjour,

Micro-entreprise INOMA (SIRET [À COMPLÉTER]), je fabrique et vends en ligne un appareil électronique décoratif basse tension (5 V USB, sans batterie, sans secteur), en boîtier imprimé en 3D.

Volumes prévus : [À COMPLÉTER] unités / an ; CA prévisionnel : [À COMPLÉTER] € ;
Pays de vente : [France / UE] ; canaux : site propre, [Etsy…].

Je souhaite un devis incluant la RC après livraison (responsabilité du fait des produits), la RC exploitation, et si possible une protection juridique. Merci de préciser plafonds, franchises, exclusions (rappel de produits, ventes hors UE).

[Nom] — [e-mail]

## H4 — Demande de documents au fabricant du module (si introuvables en ligne)

Objet : ESP32-S3-WROOM-1 — RED test reports and EU Declaration of Conformity

Hello, we are integrating the ESP32-S3-WROOM-1 module ([exact variant, e.g. N16R8]) unmodified, with its integrated PCB antenna, into a consumer product sold in the EU. Could you please provide the EU Declaration of Conformity and the RED test reports (EN 300 328, EN 301 489-1/-17, EN 62368-1, RF exposure) for this module, as well as the latest integration / hardware design guidelines? Thank you. [Name] — INOMA

## H5 — Réponse type à une réclamation sécurité

Bonjour [Nom],

Merci de nous avoir signalé ce problème. Par précaution, débranchez l'appareil et ne l'utilisez plus jusqu'à notre retour. Pourriez-vous nous envoyer : le numéro de série (étiquette sous l'appareil), des photos, le chargeur utilisé et une description de ce qui s'est passé ?

Nous revenons vers vous sous 48 h avec une solution (réparation, remplacement ou remboursement).

[Nom] — INOMA
