HARRMOS/ummati-deco/conformite/B_Declaration_UE_conformite.md

# B — Déclaration UE de conformité

> Modèle à compléter **uniquement après** avoir terminé le dossier technique (A). Langue : français (ajouter les langues des autres pays de vente). À fournir avec le produit (intégrale ou simplifiée avec lien internet).

---

## DÉCLARATION UE DE CONFORMITÉ

**N° :** DoC-AY-R1-[À COMPLÉTER : version, ex. 01]

1. **Produit :** lecteur audio décoratif avec éclairage et connexion Wi-Fi
   **Nom commercial :** AYAH « Radio »
   **Modèle / type :** AY-R1 (variantes coloris AY-R1-VE, AY-R1-NO, AY-R1-IV)
   **Version matérielle :** [À COMPLÉTER] — **Version logicielle :** [À COMPLÉTER]
   **Numéros de lot / série concernés :** à partir du lot [À COMPLÉTER]

2. **Fabricant :** INOMA, [À COMPLÉTER : forme juridique], [À COMPLÉTER : adresse postale complète], France — [À COMPLÉTER : e-mail]

3. La présente déclaration de conformité est établie **sous la seule responsabilité du fabricant**.

4. **Objet de la déclaration :** l'appareil décrit au point 1, identifiable par l'étiquette portant sa référence et son numéro de lot. [Insérer une photo du produit — facultatif]

5. L'objet de la déclaration décrit ci-dessus est conforme à la législation d'harmonisation de l'Union applicable :
   - **Directive 2014/53/UE** (équipements radioélectriques), y compris le **règlement délégué (UE) 2022/30** (articles 3.3 d, e, f) ;
   - **Directive 2011/65/UE** (RoHS), modifiée par la directive déléguée (UE) 2015/863.
   - [À VÉRIFIER : règlement (UE) 2023/826 si applicable]

6. **Références des normes harmonisées appliquées** (ou autres spécifications techniques) :
   - Article 3.1(a) — Sécurité : EN IEC 62368-1:[version] ; exposition : EN 62479:[version] ou EN 62311:[version]
   - Article 3.1(b) — CEM : EN 301 489-1 V[version] ; EN 301 489-17 V[version]
   - Article 3.2 — Spectre radio : EN 300 328 V[version]
   - Article 3.3(d)(e)(f) — Cybersécurité : EN 18031-1:[version]
   - RoHS : EN IEC 63000:[version]
   > **[À VÉRIFIER]** chaque version dans la liste officielle au JOUE à la date de signature.

7. **Organisme notifié :** sans objet — procédure d'évaluation : **contrôle interne de la fabrication (annexe II de la directive 2014/53/UE)**.
   > ⚠️ Si une norme n'est **pas appliquée entièrement** (ou si la citation de l'EN 18031-1 au JOUE l'exclut pour ton design), cette procédure **n'est pas possible** : un organisme notifié devient obligatoire.

8. **Informations complémentaires :** bande de fréquences 2 400–2 483,5 MHz ; puissance maximale émise : [À COMPLÉTER : valeur déclarée par le fabricant du module] dBm (PIRE). Accessoires : aucun chargeur fourni ; logiciel : firmware version [À COMPLÉTER].

Signé par et au nom de : INOMA

Lieu et date : [À COMPLÉTER], le [À COMPLÉTER]

Nom, fonction : [À COMPLÉTER], [ex. dirigeant]

Signature : ______________________

---

## Version simplifiée (à imprimer dans la notice)

> Le soussigné, INOMA, déclare que l'équipement radioélectrique du type **AYAH AY-R1** est conforme à la directive 2014/53/UE. Le texte complet de la déclaration UE de conformité est disponible à l'adresse internet suivante : **[À COMPLÉTER : URL]**
