HARRMOS/ummati-deco/cad/apercus/2_eclate.png

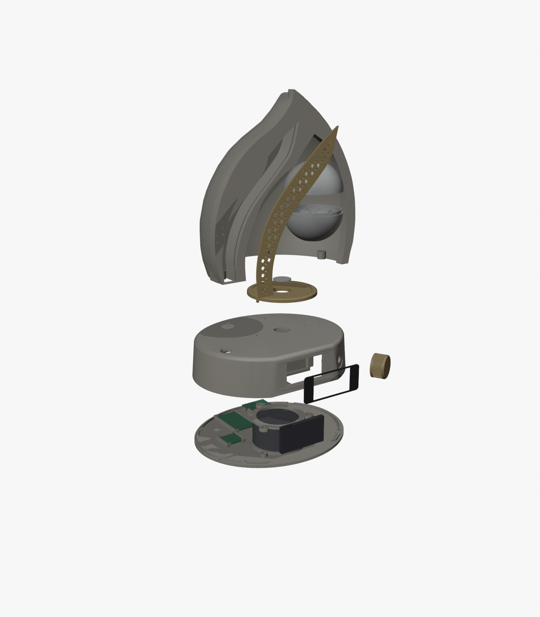
cad/apercus/2_eclate.png
