HARRMOS/ummati-deco/cad/apercus/3_fond_dessus.png

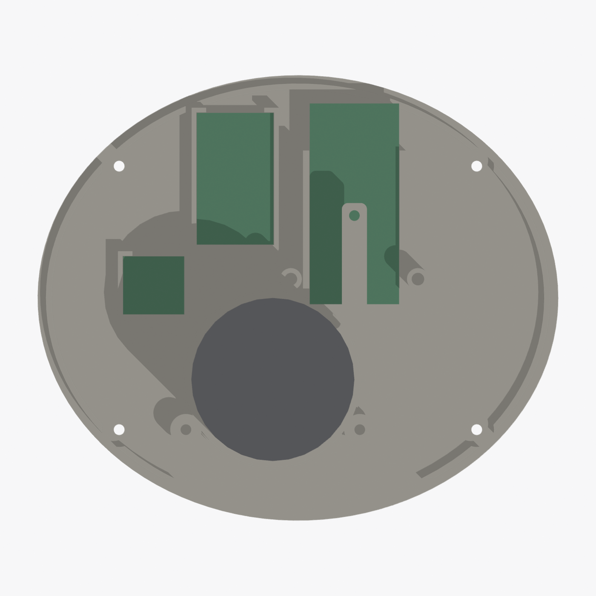
cad/apercus/3_fond_dessus.png
