HARRMOS/ummati-deco/cad/apercus/4_base_dessous.png

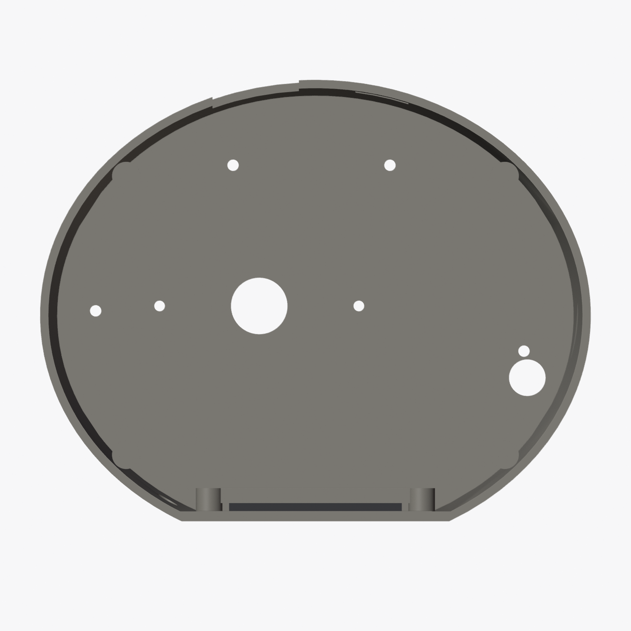
cad/apercus/4_base_dessous.png
