HARRMOS/ummati-deco/cad/apercus/5_niche_arriere.png

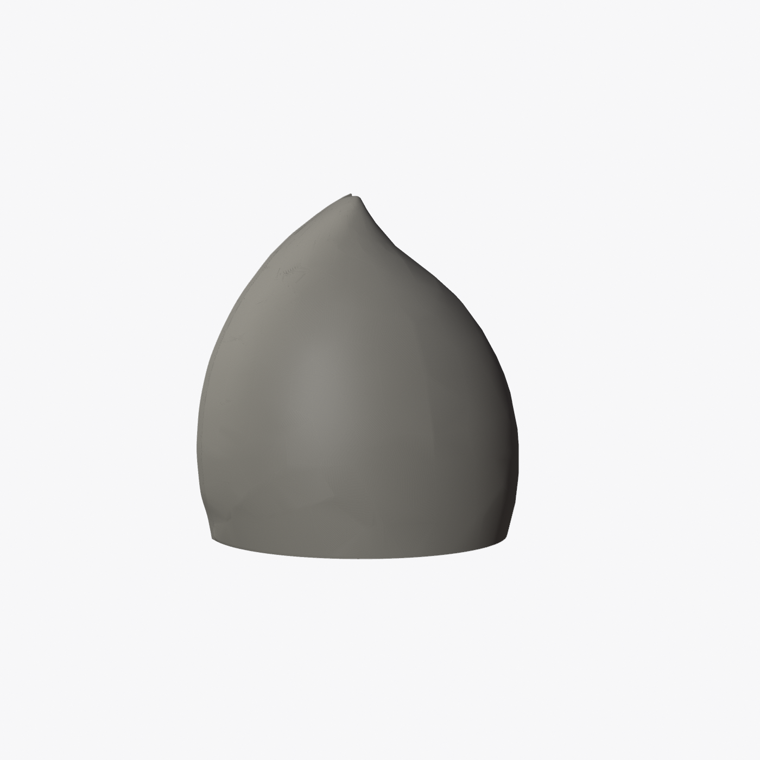
cad/apercus/5_niche_arriere.png
