HARRMOS/ummati-deco/cad/apercus/6_niche_dessous.png

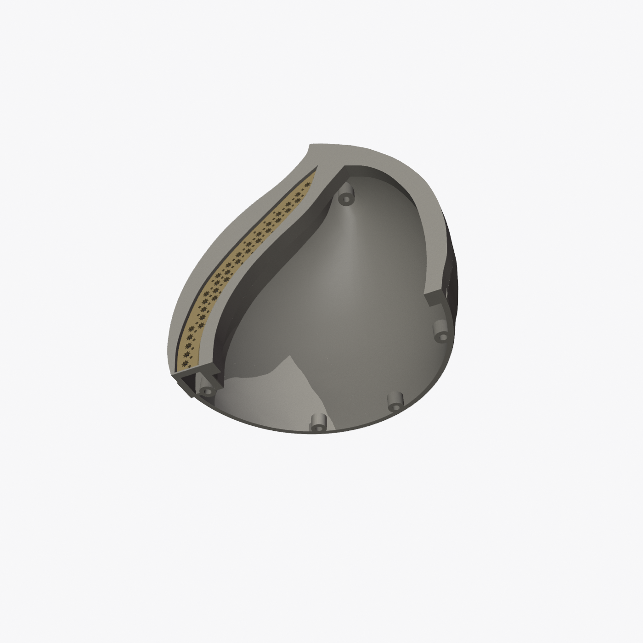
cad/apercus/6_niche_dessous.png
