HARRMOS/ummati-deco/cad/apercus/7_sphere.png

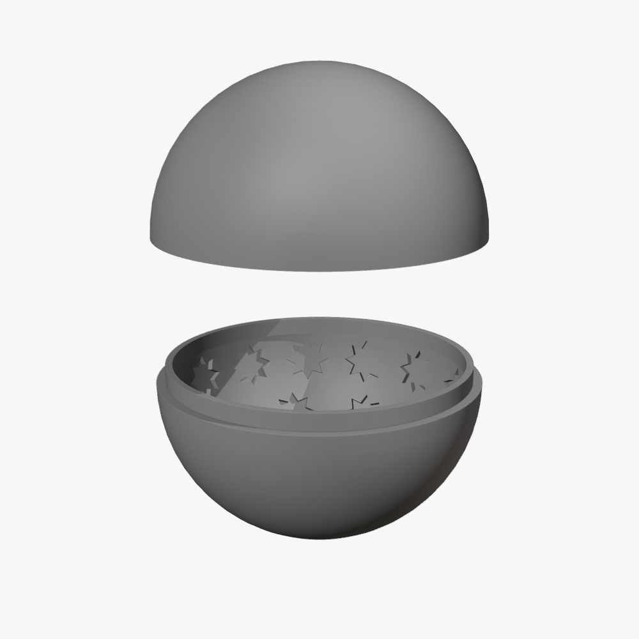
cad/apercus/7_sphere.png
