HARRMOS/ummati-deco/design/import/view_geo_34.png

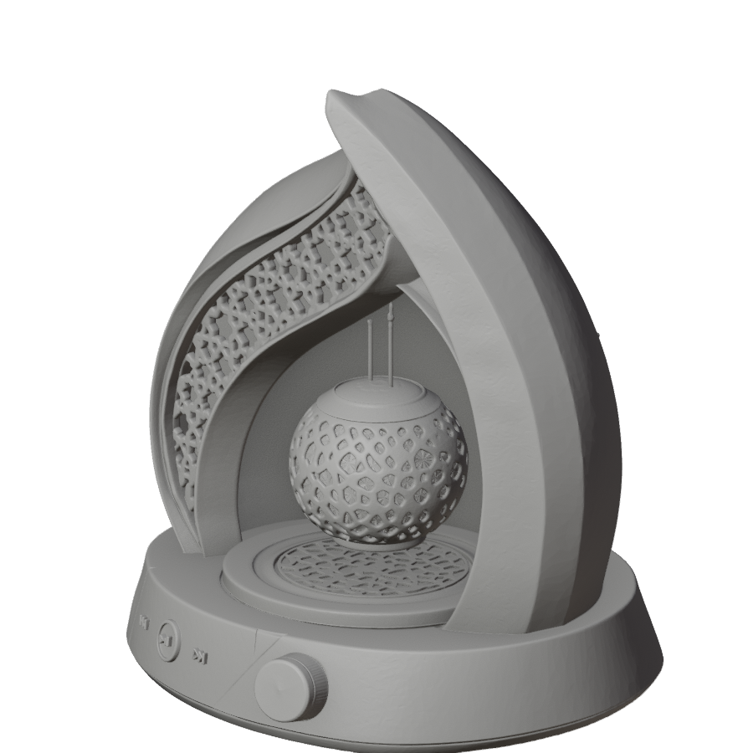
design/import/view_geo_34.png
