HARRMOS/ummati-deco/design/import/view_geo_back.png

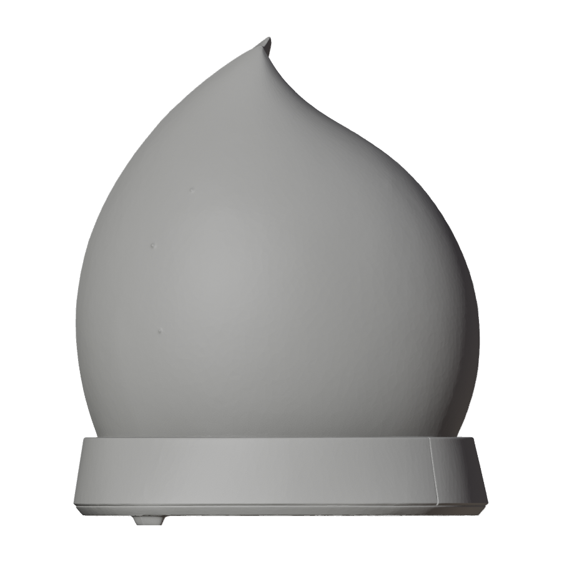
design/import/view_geo_back.png
