HARRMOS/ummati-deco/design/import/view_geo_front.png

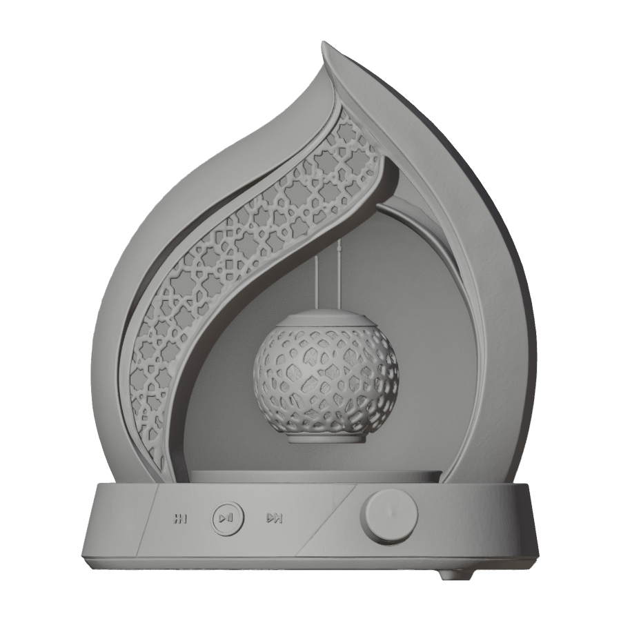
design/import/view_geo_front.png
