HARRMOS/ummati-deco/design/import/view_geo_side.png

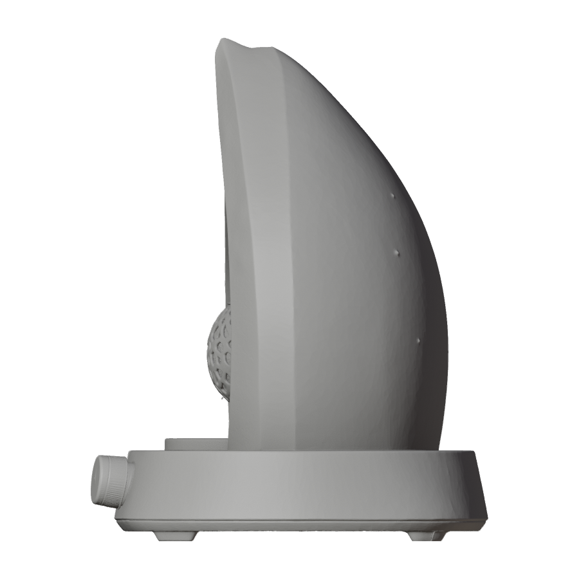
design/import/view_geo_side.png
