HARRMOS/ummati-deco/design/import/view_geo_top.png

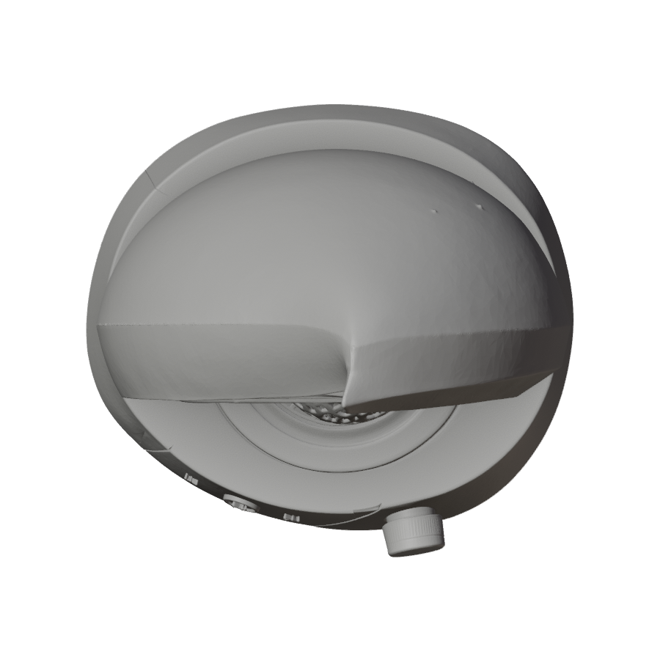
design/import/view_geo_top.png
