HARRMOS/ummati-deco/design/import/view_tex_34.png

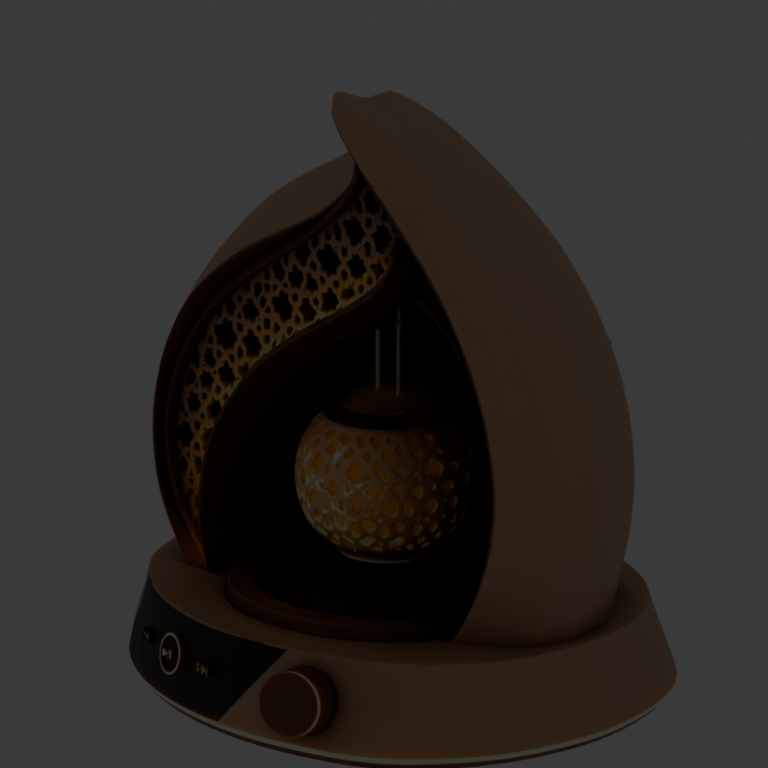
design/import/view_tex_34.png
