HARRMOS/ummati-deco/design/import/view_tex_back.png

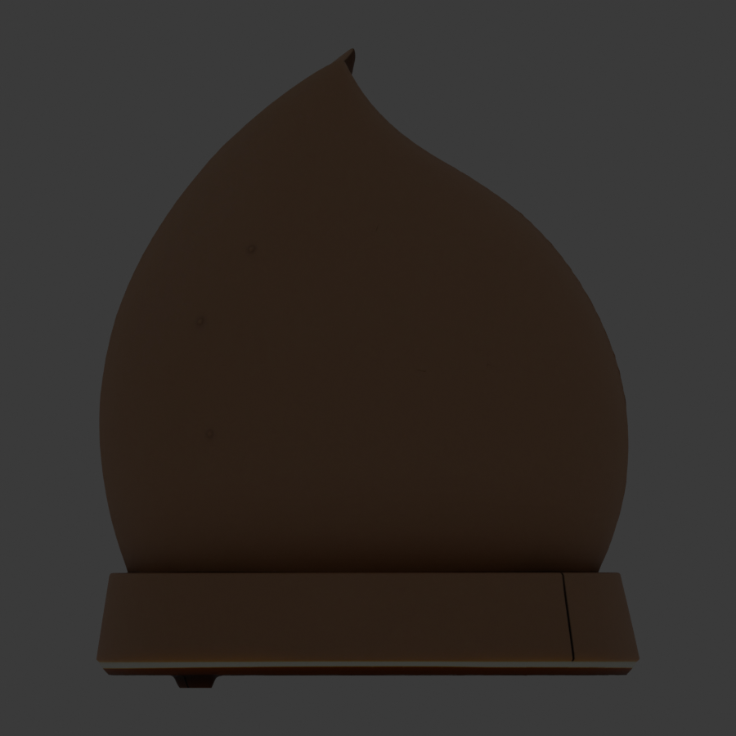
design/import/view_tex_back.png
