HARRMOS/ummati-deco/design/import/view_tex_front.png

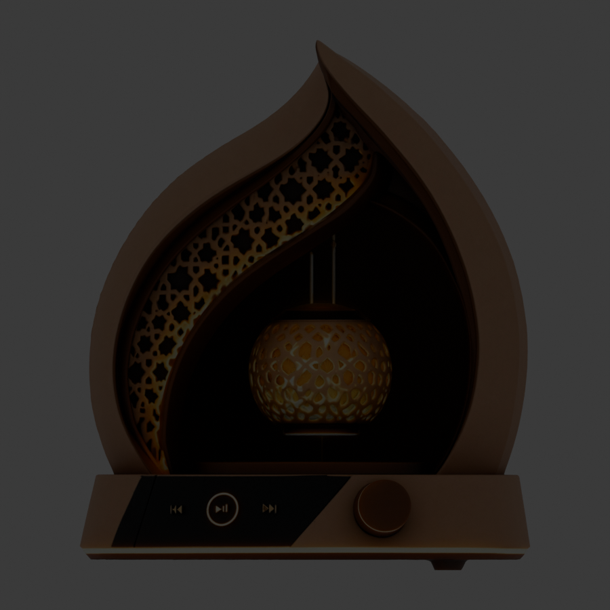
design/import/view_tex_front.png
