HARRMOS/ummati-deco/design/import/view_tex_side.png

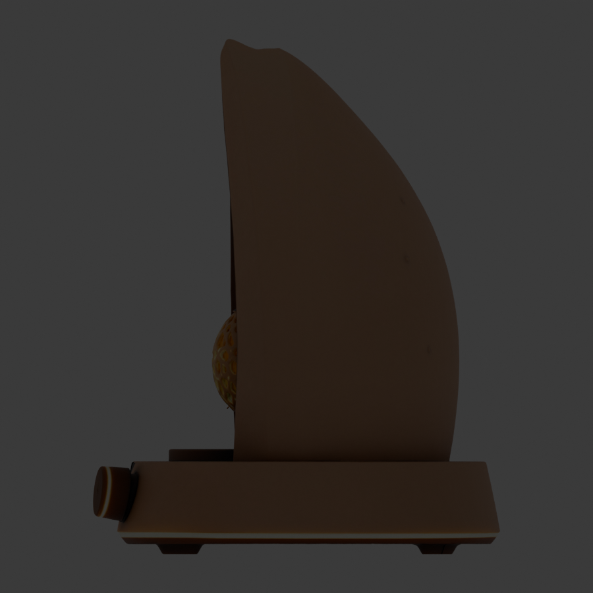
design/import/view_tex_side.png
