HARRMOS/ummati-deco/design/import/view_tex_top.png

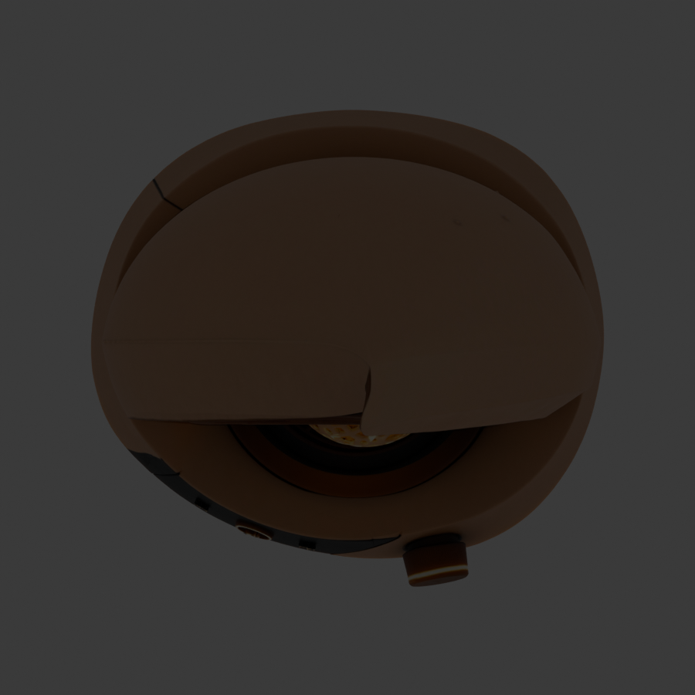
design/import/view_tex_top.png
