HARRMOS/ummati-deco/design/panel_ui.png

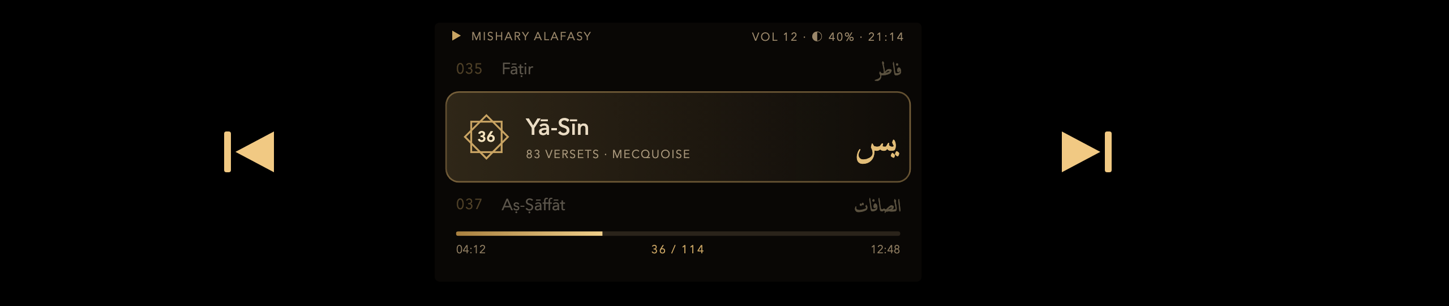
design/panel_ui.png
