HARRMOS/ummati-deco/design/renders/ayah_ivory_hero.png

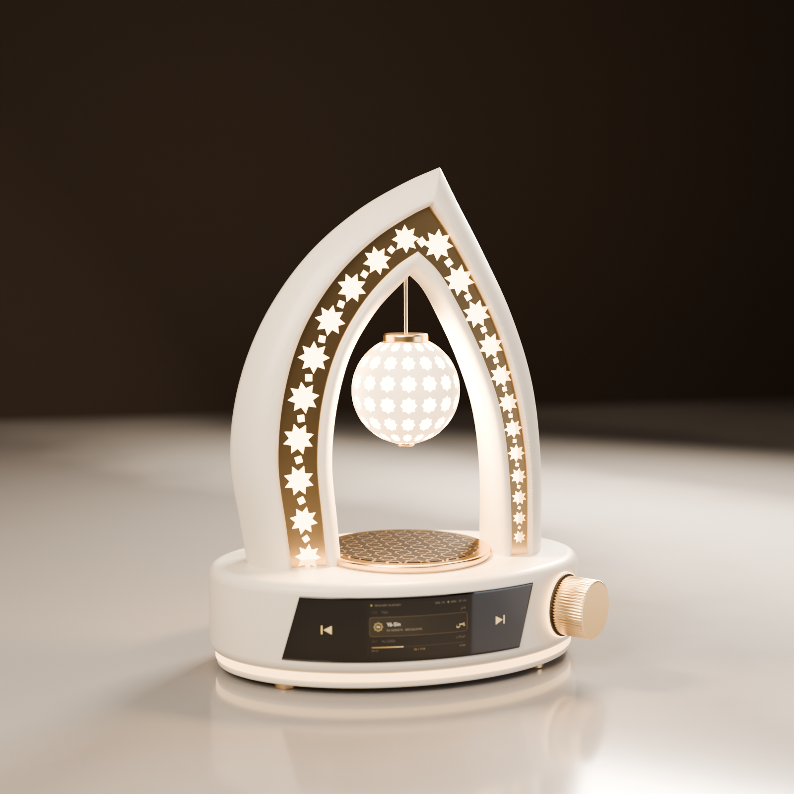
design/renders/ayah_ivory_hero.png
