HARRMOS/ummati-deco/design/renders/ayah_ivory_screen.png

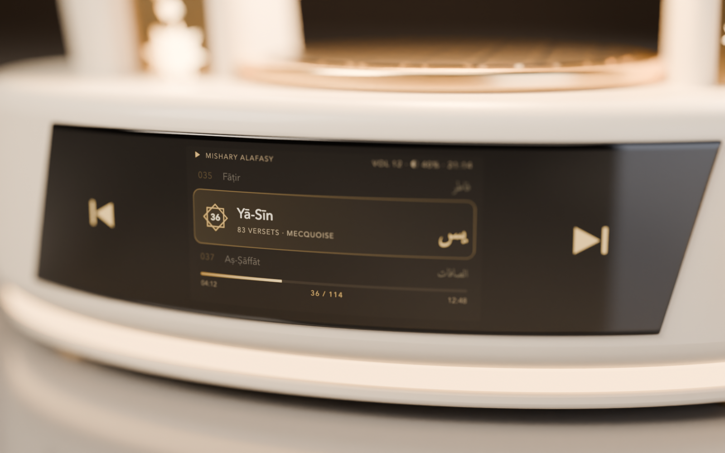
design/renders/ayah_ivory_screen.png
