HARRMOS/ummati-deco/design/renders/ayah_ivory_trois-quarts.png

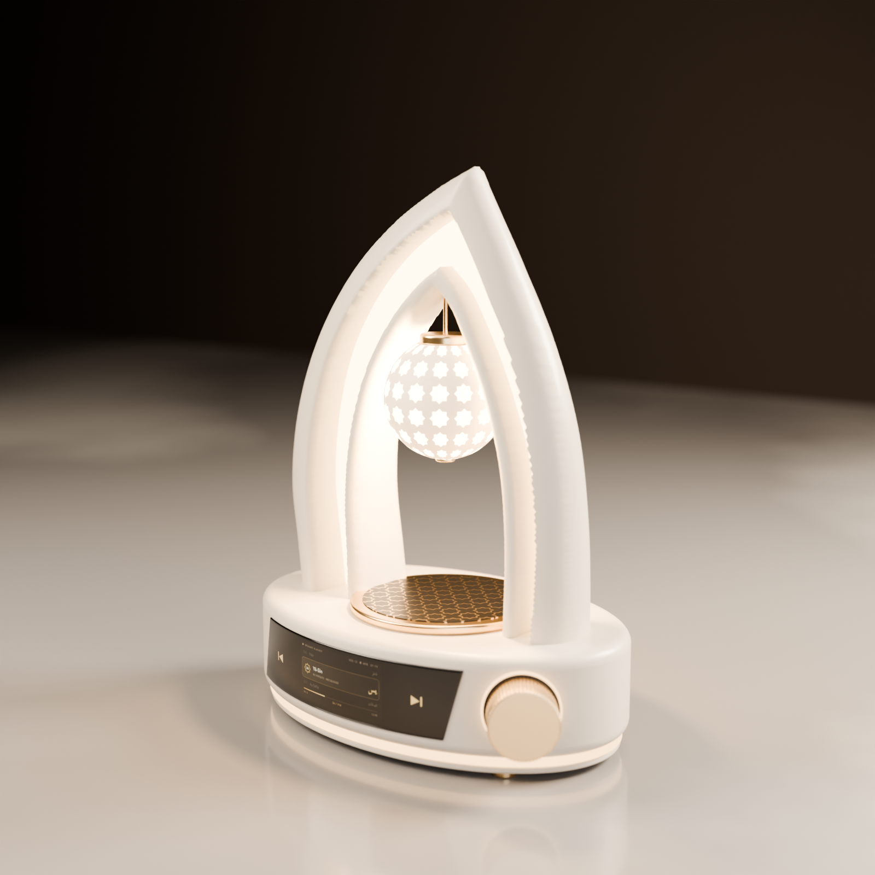
design/renders/ayah_ivory_trois-quarts.png
