HARRMOS/ummati-deco/design/renders/v1/ayah_black_hero.png

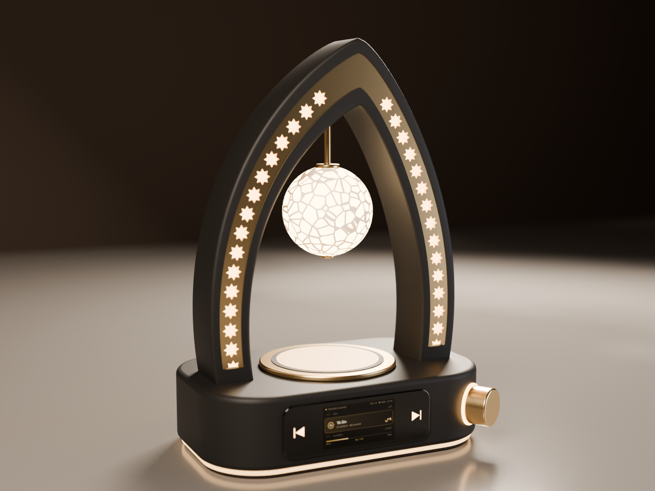
design/renders/v1/ayah_black_hero.png
