HARRMOS/ummati-deco/design/renders/v1/ayah_grey_hero.png

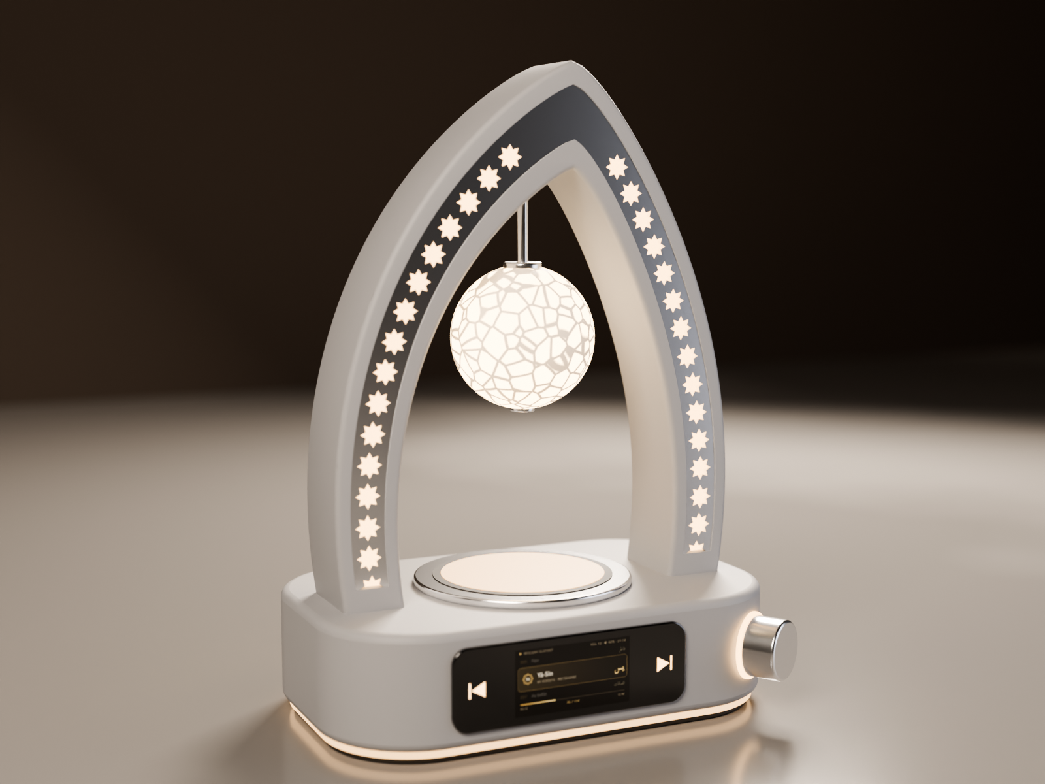
design/renders/v1/ayah_grey_hero.png
