HARRMOS/ummati-deco/design/renders/v1/ayah_ivory_front.png

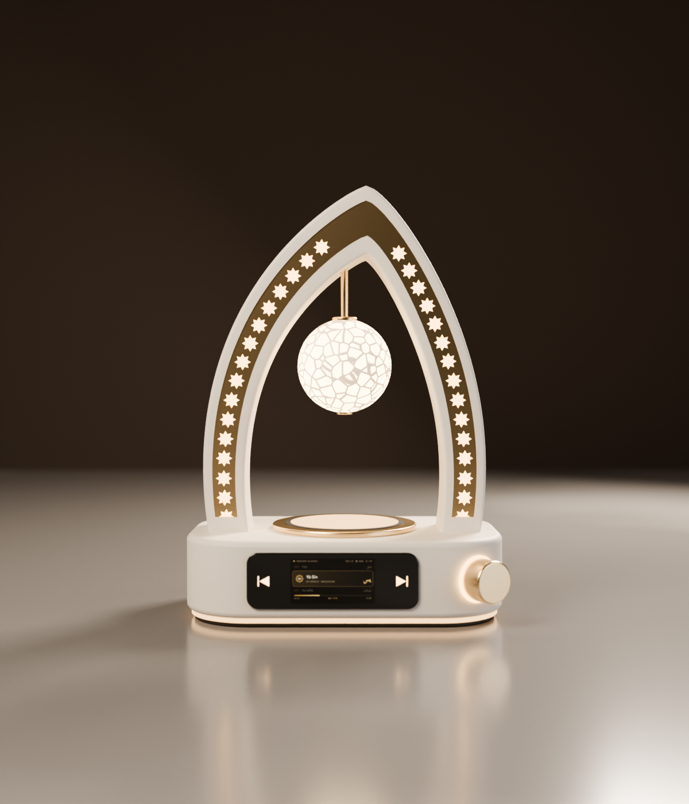
design/renders/v1/ayah_ivory_front.png
