HARRMOS/ummati-deco/design/renders/v1/ayah_ivory_screen.png

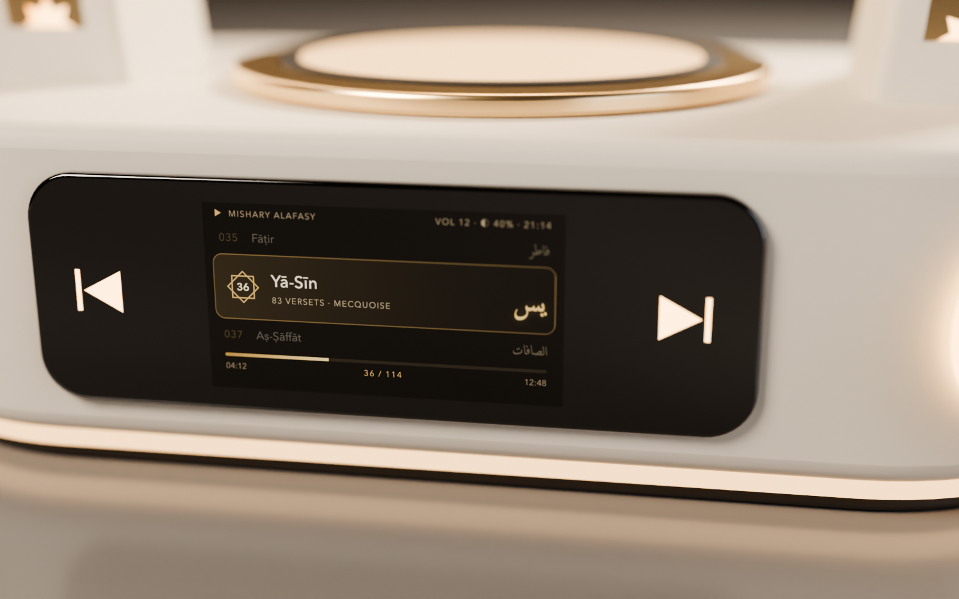
design/renders/v1/ayah_ivory_screen.png
