HARRMOS/ummati-deco/design/renders/v3_ivory_arriere.png

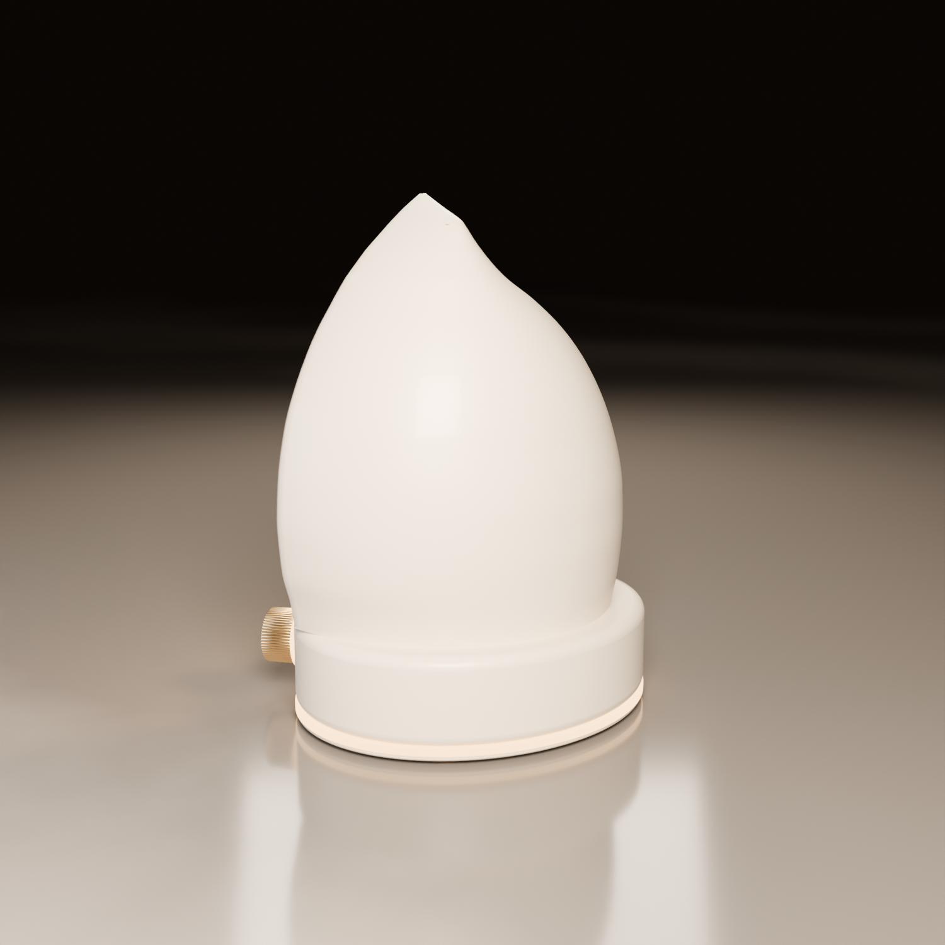
design/renders/v3_ivory_arriere.png
