HARRMOS/ummati-deco/design/renders/v3_ivory_ecran.png

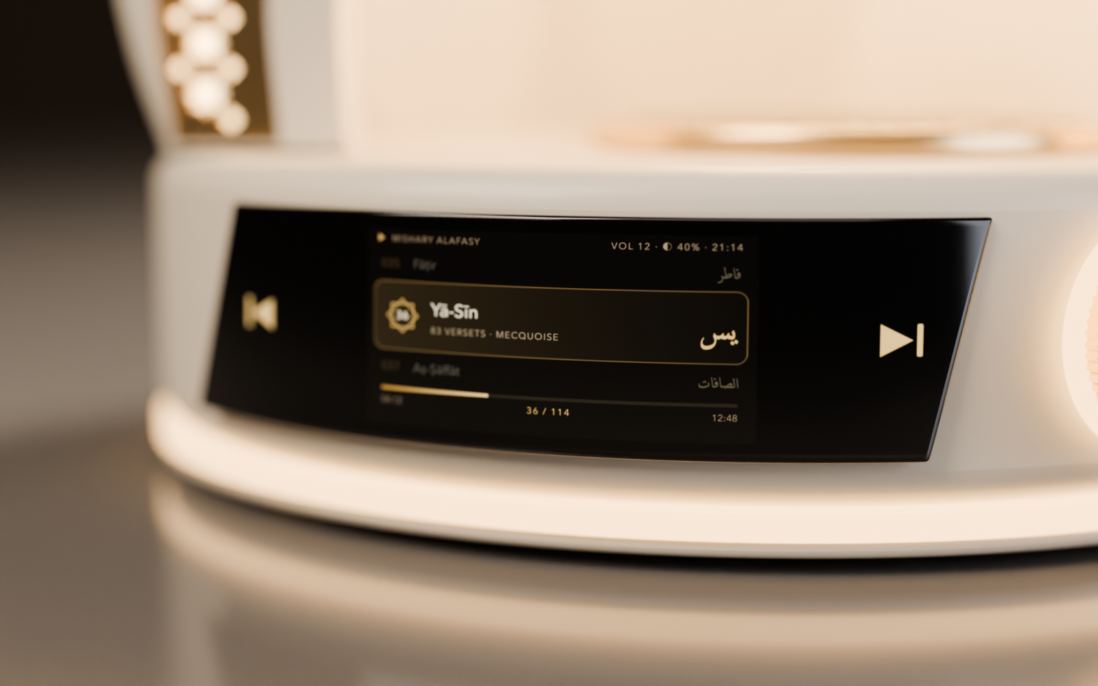
design/renders/v3_ivory_ecran.png
