HARRMOS/ummati-deco/design/renders/v3_ivory_face.png

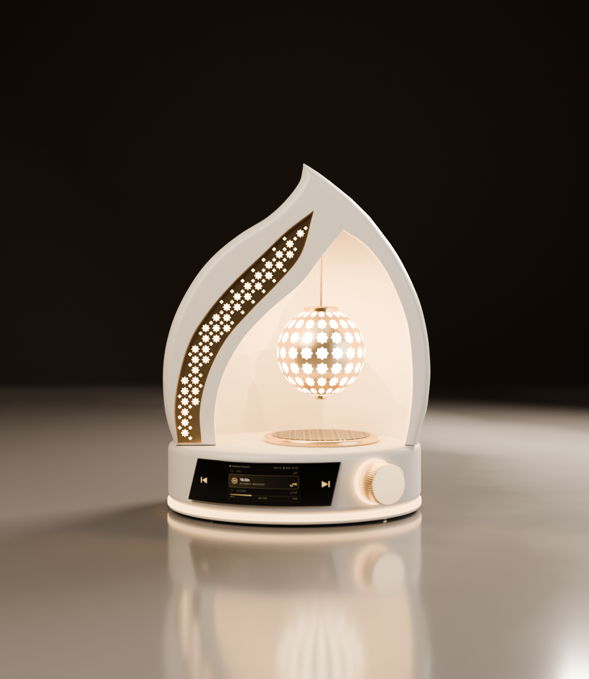
design/renders/v3_ivory_face.png
