HARRMOS/ummati-deco/design/screen_ui.png

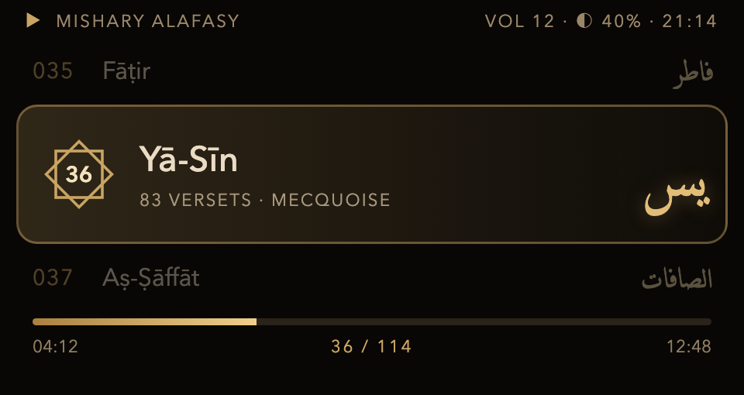
design/screen_ui.png
