HARRMOS/ummati-deco/radio/calligraphie/texte.png

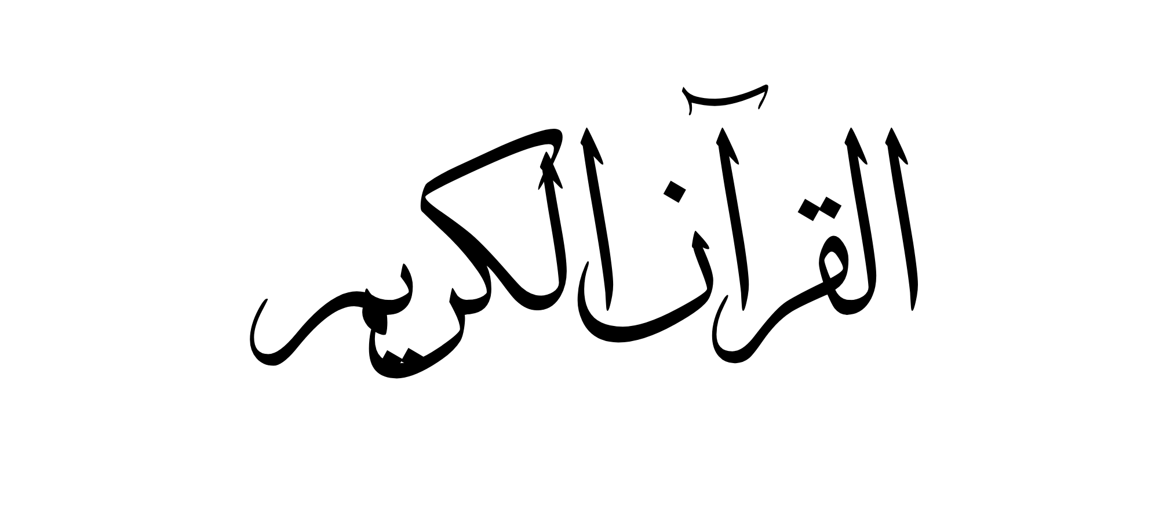
radio/calligraphie/texte.png
