HARRMOS/ummati-deco/cad/step/08_cadre_ecran_NOIR.step

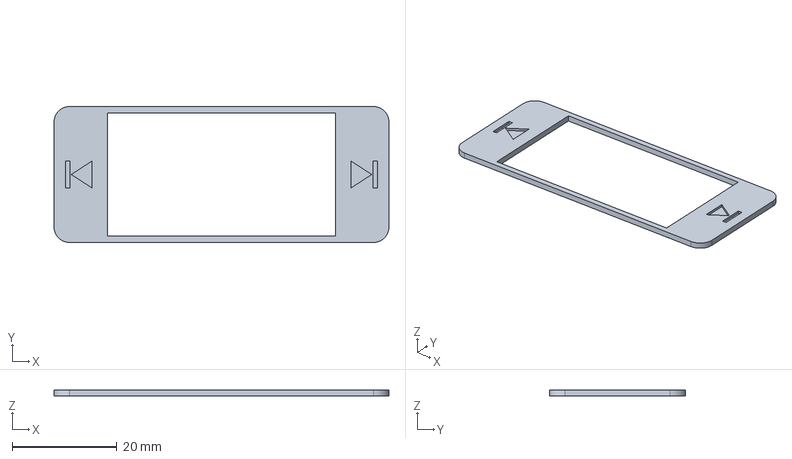
[picture p41: CAD file, 2026-11-02]
cad/step/08_cadre_ecran_NOIR.step
64.0 x 26.0 x 1.20 mm
