HARRMOS/ummati-deco/cad/stl/01_niche_coque.stl

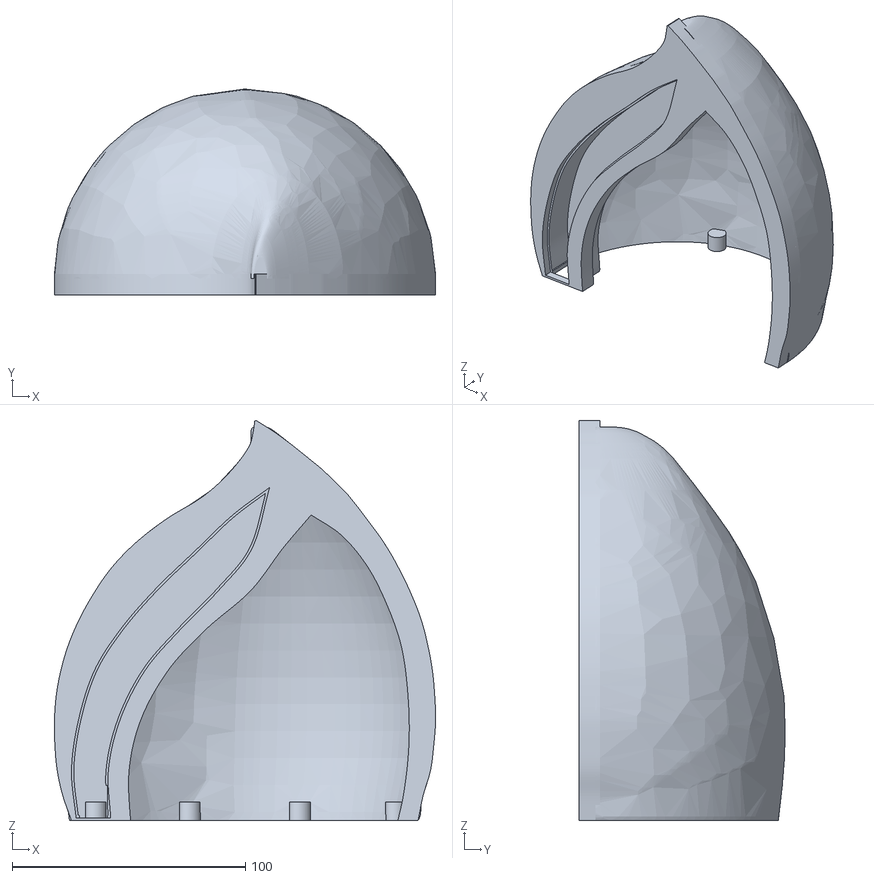
[picture p42: CAD file, 2026-11-02]
cad/stl/01_niche_coque.stl
163.6 x 88.4 x 171.7
