HARRMOS/ummati-deco/design/ayah_v3_maquette.stl

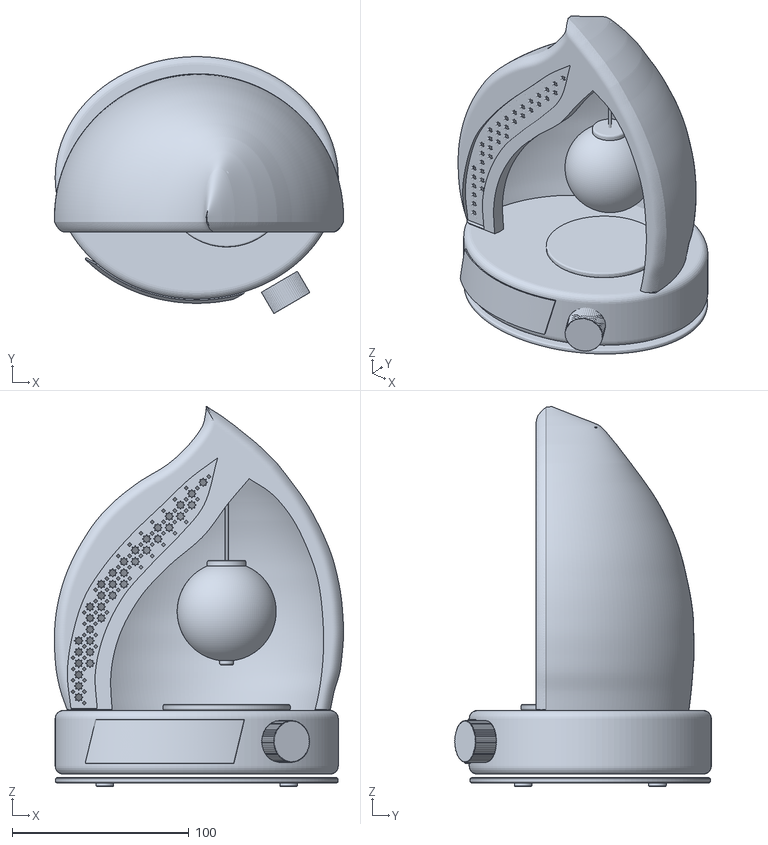
[picture p43: CAD file, 2026-11-02]
design/ayah_v3_maquette.stl
163.6 x 145.3 x 215.0
