HARRMOS/ummati-deco/radio/step/10_touche_precedent_OR.step

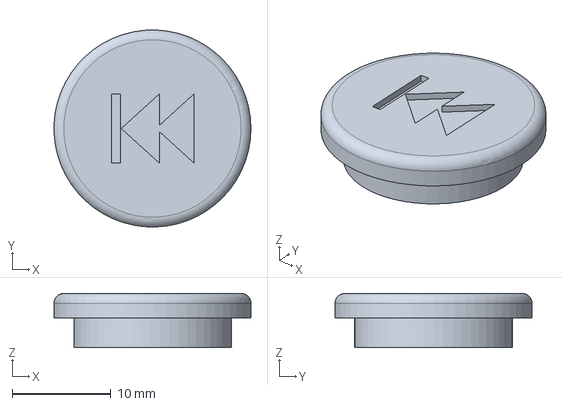
[picture p44: CAD file, 2026-11-02]
radio/step/10_touche_precedent_OR.step
20.0 x 20.0 x 5.50 mm
