HARRMOS/ummati-deco/cad/step/05_bride_haut_parleur.step

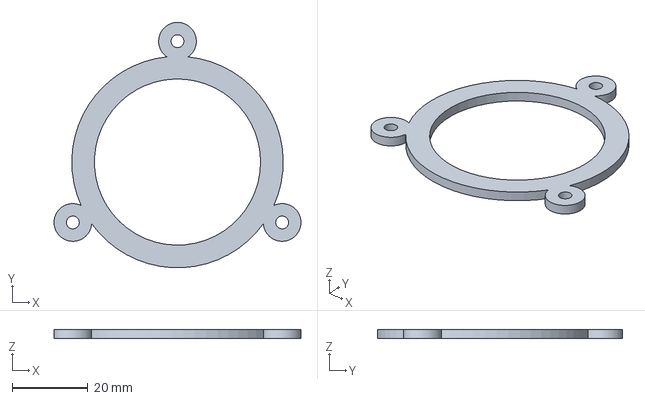
[picture p45: CAD file, 2026-11-02]
cad/step/05_bride_haut_parleur.step
65.4 x 64.9 x 2.50 mm
