HARRMOS/ummati-deco/radio/step/11_touche_lecture_OR.step

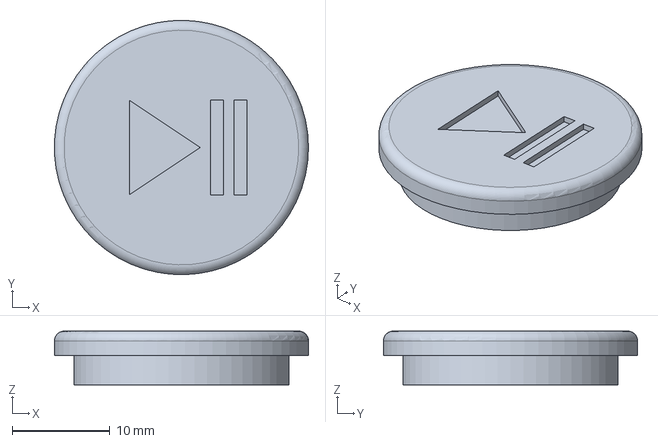
[picture p46: CAD file, 2026-11-02]
radio/step/11_touche_lecture_OR.step
26.0 x 26.0 x 5.50 mm
