HARRMOS/ummati-deco/cad/step/04_fond_electronique.step

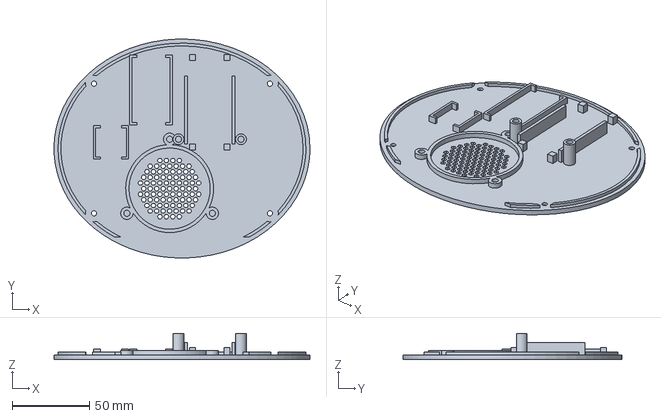
[picture p47: CAD file, 2026-11-02]
cad/step/04_fond_electronique.step
166.0 x 141.9 x 17.0 mm
