HARRMOS/ummati-deco/radio/step/09_molette_OR.step

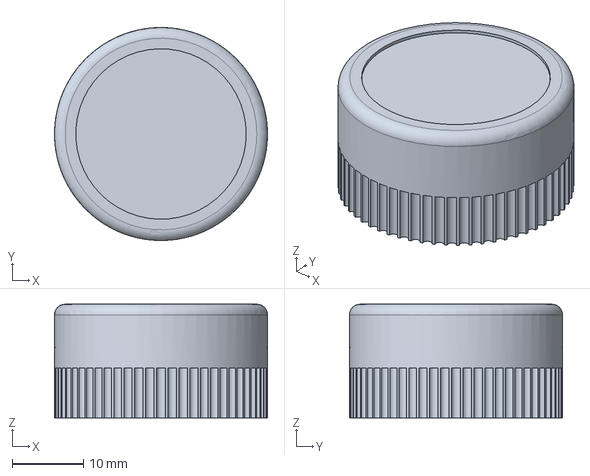
[picture p48: CAD file, 2026-11-02]
radio/step/09_molette_OR.step
30.0 x 30.0 x 16.0 mm
