HARRMOS/ummati-deco/cad/step/10_socle_OR.step

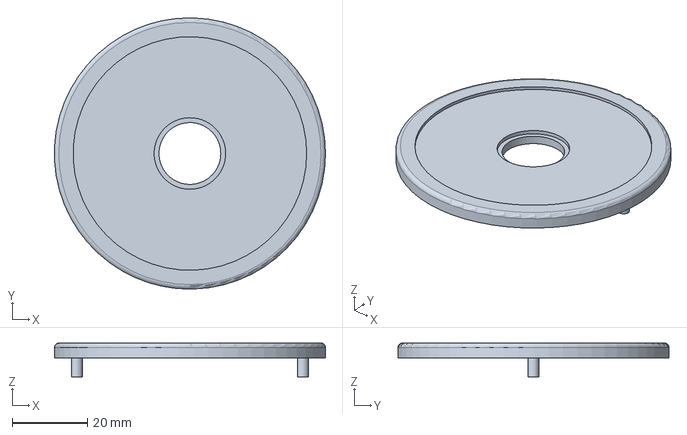
[picture p49: CAD file, 2026-11-02]
cad/step/10_socle_OR.step
71.9 x 72.0 x 9.00 mm
