HARRMOS/ummati-deco/radio/step/05_bague_HP_x2.step

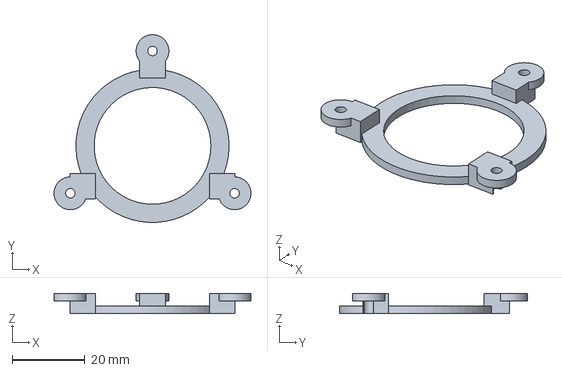
[picture p50: CAD file, 2026-11-02]
radio/step/05_bague_HP_x2.step
54.0 x 51.5 x 5.50 mm
