HARRMOS/ummati-deco/cad/step/07_support_ecran.step

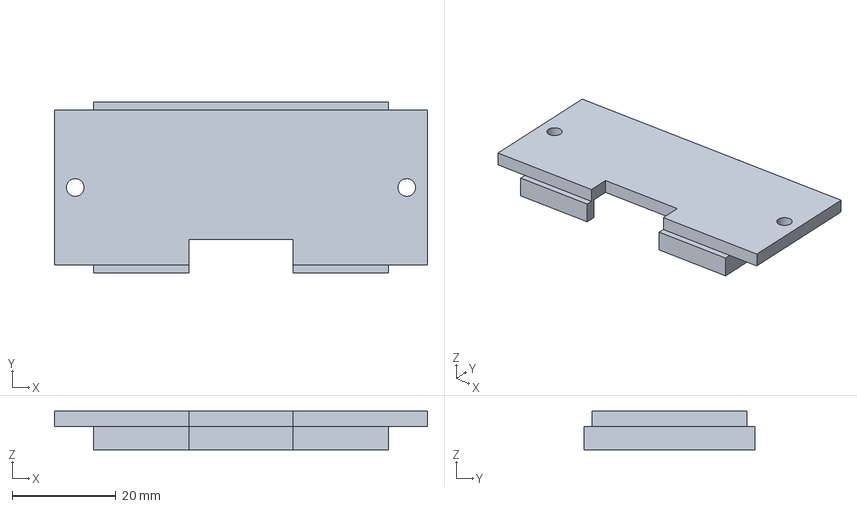
[picture p51: CAD file, 2026-11-02]
cad/step/07_support_ecran.step
72.0 x 33.0 x 7.50 mm
