HARRMOS/ummati-deco/radio/step/03_plaque_calligraphie_NOIR+OR.step

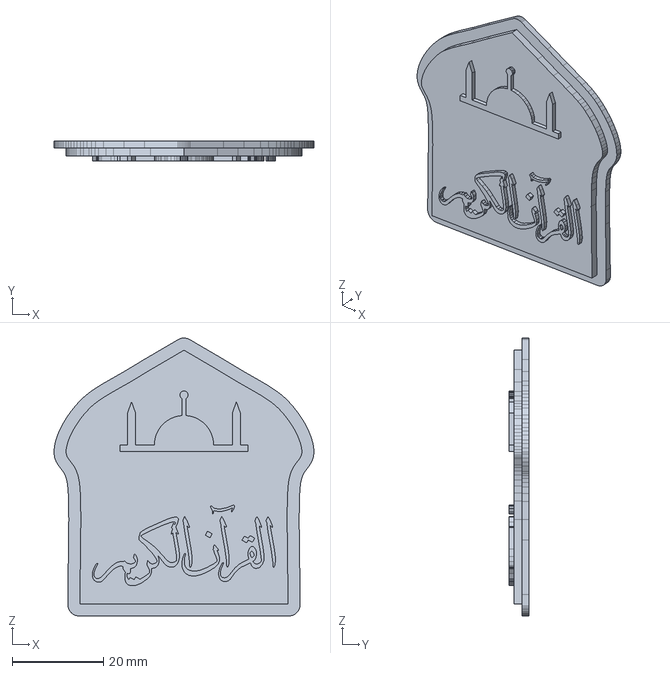
[picture p52: CAD file, 2026-11-02]
radio/step/03_plaque_calligraphie_NOIR+OR.step
57.0 x 4.30 x 61.0 mm
