HARRMOS/ummati-deco/cad/step/06_barrette_esp32.step

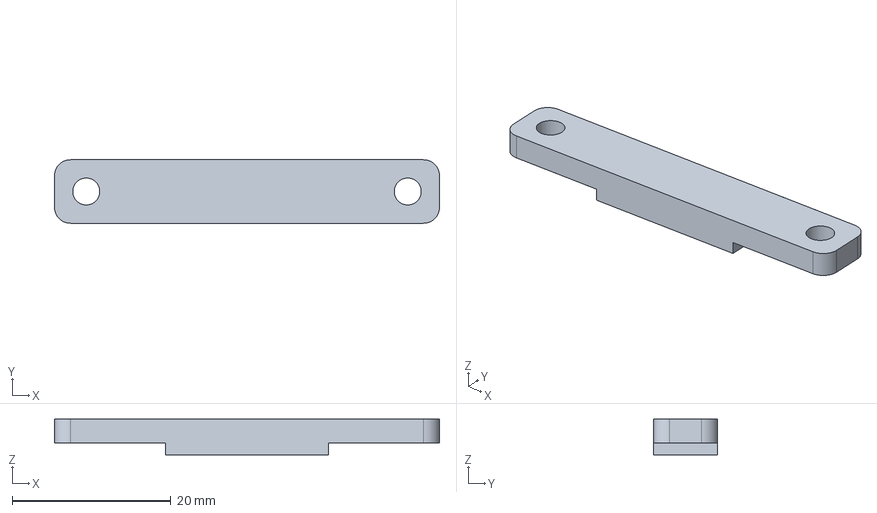
[picture p53: CAD file, 2026-11-02]
cad/step/06_barrette_esp32.step
48.5 x 8.00 x 4.50 mm
