HARRMOS/ummati-deco/radio/step/04_baffle.step

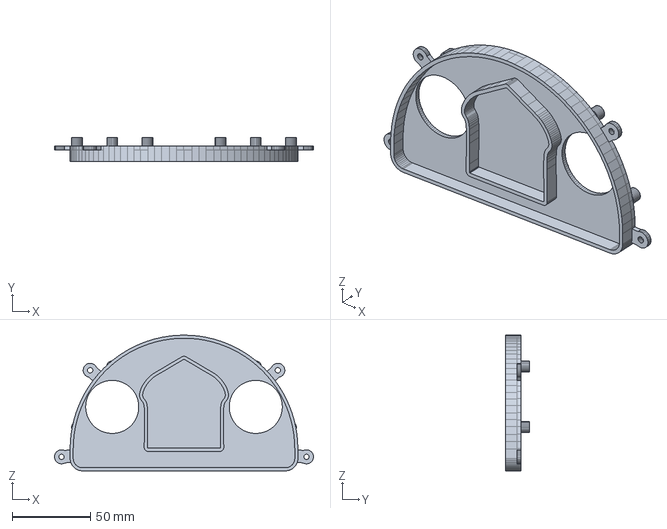
[picture p54: CAD file, 2026-11-02]
radio/step/04_baffle.step
166.0 x 15.5 x 87.0 mm
