HARRMOS/ummati-deco/cad/step/09_molette_OR.step

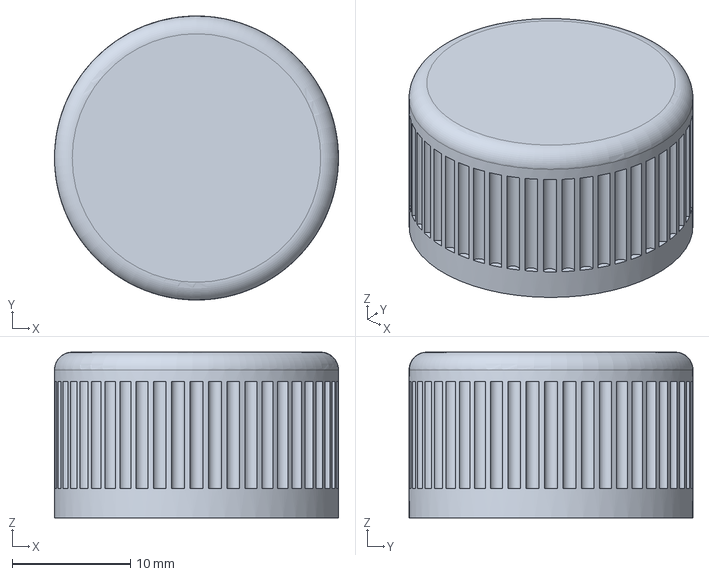
[picture p55: CAD file, 2026-11-02]
cad/step/09_molette_OR.step
24.0 x 24.0 x 14.0 mm
