HARRMOS/ummati-deco/cad/step/12_sphere_haut_BLANC.step

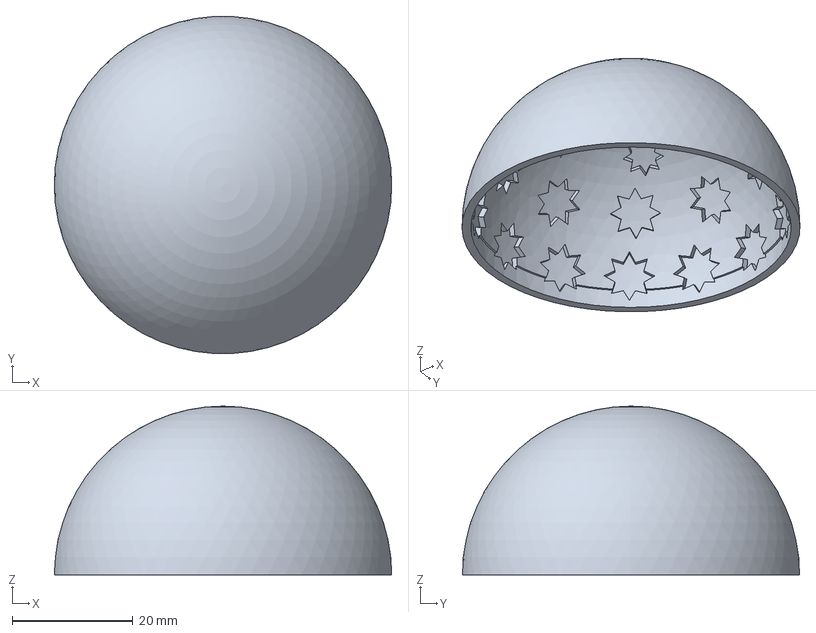
[picture p56: CAD file, 2026-11-02]
cad/step/12_sphere_haut_BLANC.step
56.0 x 55.9 x 28.0 mm
