HARRMOS/ummati-deco/radio/step/02_grille_OR.step

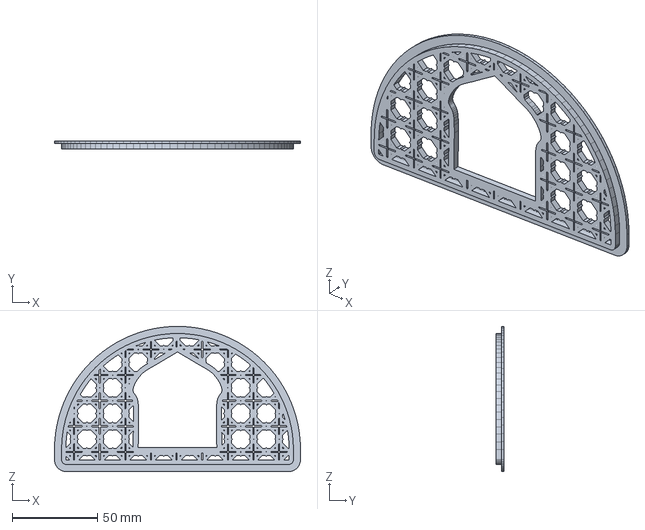
[picture p57: CAD file, 2026-11-02]
radio/step/02_grille_OR.step
144.0 x 4.50 x 85.0 mm
