HARRMOS/ummati-deco/cad/step/03_base_coque.step

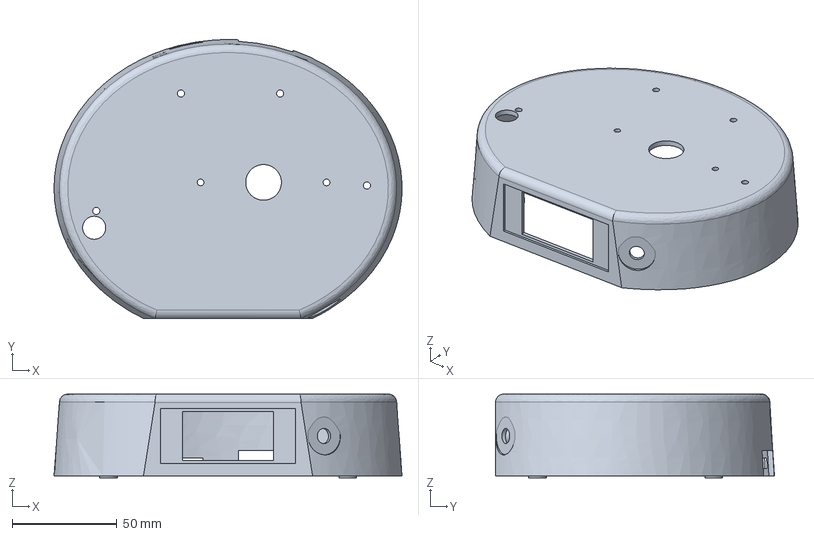
[picture p58: CAD file, 2026-11-02]
cad/step/03_base_coque.step
165.8 x 132.9 x 40.0 mm
