HARRMOS/ummati-deco/radio/step/01_corps.step

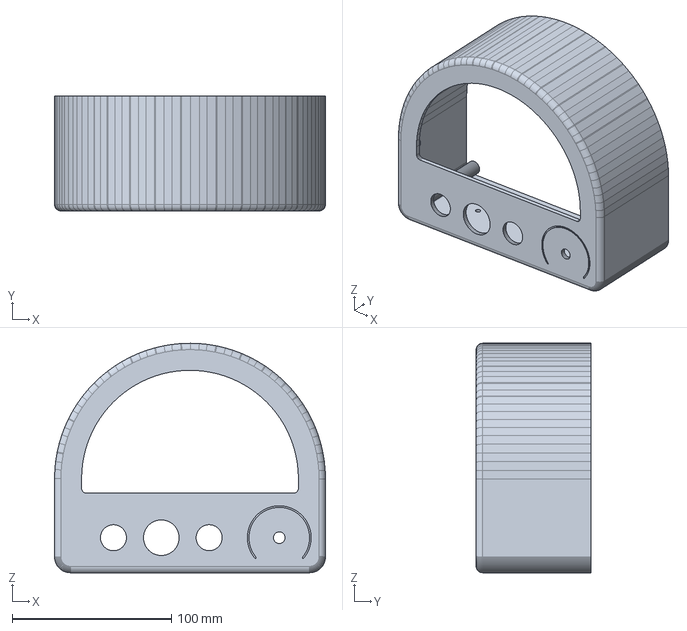
[picture p59: CAD file, 2026-11-02]
radio/step/01_corps.step
170.0 x 72.0 x 144.0 mm
