HARRMOS/ummati-deco/cad/step/13_sphere_bas_BLANC.step

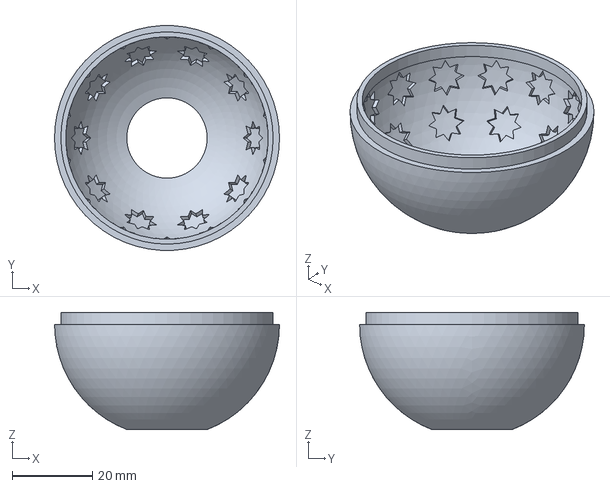
[picture p60: CAD file, 2026-11-02]
cad/step/13_sphere_bas_BLANC.step
56.0 x 55.9 x 29.2 mm
