HARRMOS/ummati-deco/radio/step/08_socle_OR.step

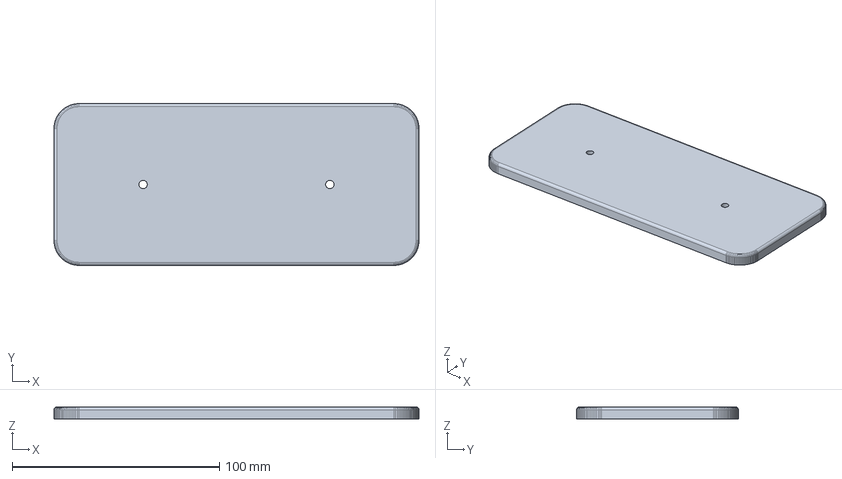
[picture p61: CAD file, 2026-11-02]
radio/step/08_socle_OR.step
176.0 x 78.0 x 6.00 mm
