HARRMOS/ummati-deco/cad/step/02_panneau_ajoure_OR.step

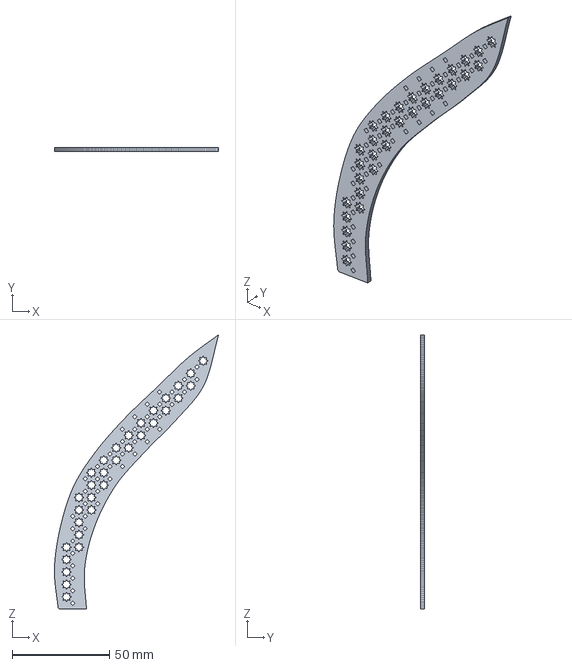
[picture p62: CAD file, 2026-11-02]
cad/step/02_panneau_ajoure_OR.step
84.6 x 2.00 x 141.2 mm
