HARRMOS/ummati-deco/cad/step/11_diffuseur_BLANC.step

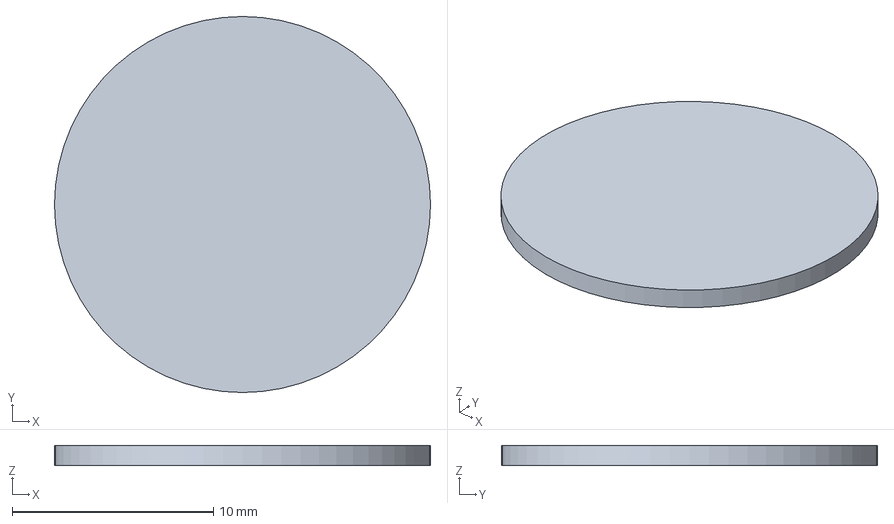
[picture p63: CAD file, 2026-11-02]
cad/step/11_diffuseur_BLANC.step
18.7 x 18.7 x 1.00 mm
