HARRMOS/ummati-deco/radio/step/06_dos_electronique.step

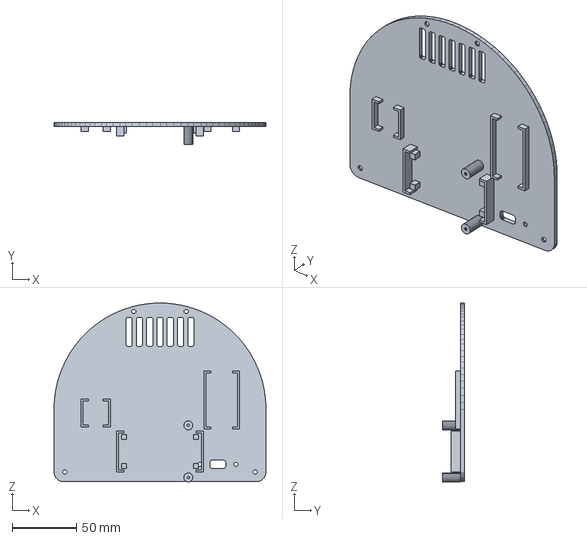
[picture p64: CAD file, 2026-11-02]
radio/step/06_dos_electronique.step
164.9 x 17.0 x 139.2 mm
