HARRMOS/ummati-deco/(list of files, cad)

Other CAD files:
radio/step/07_barrette_esp32.step
radio/step/12_touche_suivant_OR.step
cad/stl/02_panneau_ajoure_OR.stl
cad/stl/03_base_coque.stl
cad/stl/04_fond_electronique.stl
cad/stl/05_bride_haut_parleur.stl
cad/stl/06_barrette_esp32.stl
cad/stl/07_support_ecran.stl
cad/stl/08_cadre_ecran_NOIR.stl
cad/stl/09_molette_OR.stl
cad/stl/10_socle_OR.stl
cad/stl/11_diffuseur_BLANC.stl
cad/stl/12_sphere_haut_BLANC.stl
cad/stl/13_sphere_bas_BLANC.stl
design/ayah_v3_ivory.blend
radio/stl/01_corps.stl
radio/stl/02_grille_OR.stl
radio/stl/03_plaque_calligraphie_NOIR+OR.stl
radio/stl/04_baffle.stl
radio/stl/05_bague_HP_x2.stl
radio/stl/06_dos_electronique.stl
radio/stl/07_barrette_esp32.stl
radio/stl/08_socle_OR.stl
radio/stl/09_molette_OR.stl
radio/stl/10_touche_precedent_OR.stl
radio/stl/11_touche_lecture_OR.stl
radio/stl/12_touche_suivant_OR.stl
