HARRMOS/ummati-deco/cad/apercus/1_assemble.png

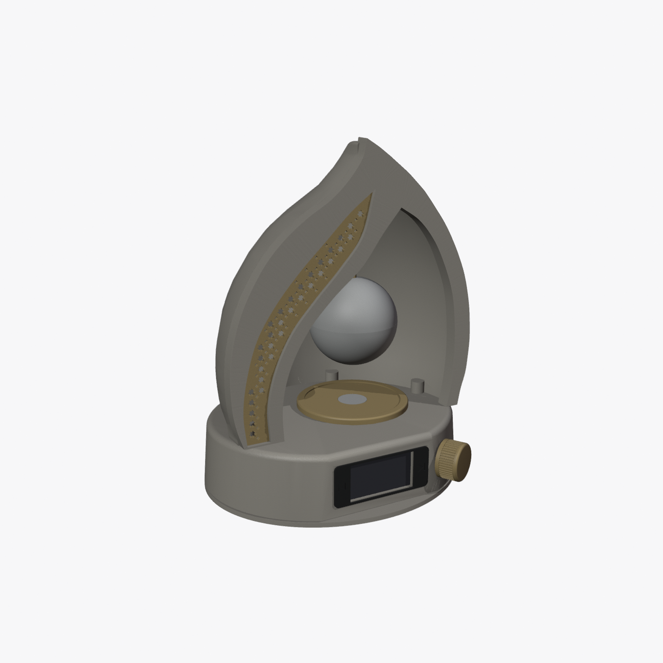
cad/apercus/1_assemble.png
