HARRMOS/ummati-deco/(commit log)

2026-11-02 AYAH : design Blender (v1-v3), interface écran et firmware ESP32-S3 de test
    [ayah_v3_ivory.blend, ayah_v3_maquette.stl]
2026-11-02 CAO : 13 pièces imprimables (niche, base, fond électronique, sphère...), visserie et guide d'assemblage
    [01_niche_coque.stl, 02_panneau_ajoure_OR.step, 02_panneau_ajoure_OR.stl, 03_base_coque.step, 03_base_coque.stl, 04_fond_electronique.step, 04_fond_electronique.stl, 05_bride_haut_parleur.step]
2026-11-02 Version Radio : 12 pièces imprimables, calligraphie en relief, ordre d'impression
    [01_corps.step, 01_corps.stl, 02_grille_OR.step, 02_grille_OR.stl, 03_plaque_calligraphie_NOIR+OR.step, 03_plaque_calligraphie_NOIR+OR.stl, 04_baffle.step, 04_baffle.stl]
2026-11-02 Dossier de conformité et de commercialisation AYAH (modèles à compléter)
